pfeffermominee690-afk/ti60-five-style-fit34/README.md

# 流光绘影：FPGA 实时视频风格化系统

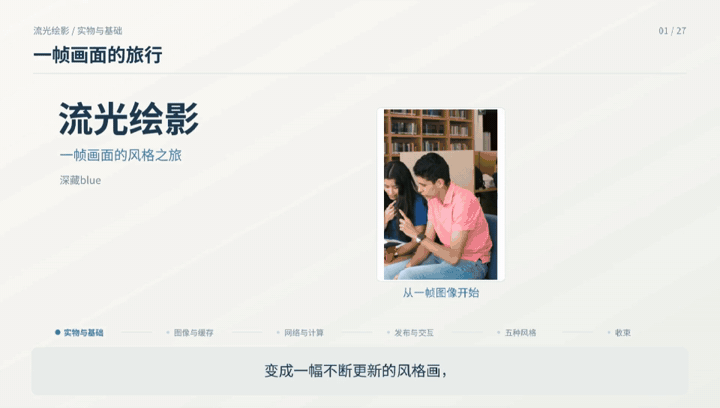
[picture p1: docs/media/previews/liuguang-showcase.gif]
流光绘影完整视频动态预览，点击播放 (https://pfeffermominee690-afk.github.io/ti60-five-style-fit34/)


**[▶ 播放完整视频 · 原理与成果展示](https://pfeffermominee690-afk.github.io/ti60-five-style-fit34/)**　960×544 · 8 分 28 秒　[下载 MP4 原片](https://github.com/pfeffermominee690-afk/ti60-five-style-fit34/releases/download/showcase-selected-20261105/liuguang-selected.mp4)

本项目运行于 Ti60F225 开发板，使用 SC431HAI CSI 摄像头采集图像，经 FPGA 处理后输出至 HDMI 显示屏。工程包含五种神经网络风格、独立 Sobel 线条 Demo，以及从板载 Flash 加载程序和模型的开机自启动实现。

当前主工程为 **fit37**：保留 fit34 的 Bayer 彩点修正、自动曝光与色彩参数，将图像和 UI 整屏旋转 180°，适配屏幕安装方向。已通过真实 J4 摄像头及充电宝断电重启验证：自动出画面、方向正确、无蓝点、手势切换正常。版本与验证资料见 [fit37 说明](docs/validation/fit37/README.md)，历史版本见 [fit34 恢复材料](recovery/fit34/README.md)。

## 实机效果

摄像头采集、FPGA 风格化、HDMI 输出。以下 15 张五风格实拍按场景分组，展示副本裁去屏幕上方的面板留白，保留完整屏幕、原图对照和风格名称；点击图片可查看未裁剪原照。

[视频演示 · 4 段](#视频演示) · [现实人物 · 5 张](#现实人物) · [手机人物 · 7 张](#手机人物) · [风景 · 3 张](#风景) · [基础线稿 Demo](#基础线稿-demo)

### 视频演示

四段实机视频展示五种风格的场景与人物效果、独立线条处理和手势切换。点击动图查看完整视频；场景与人物动图为片段预览。

<table>
<tr>
<td width="50%" align="center" valign="top">
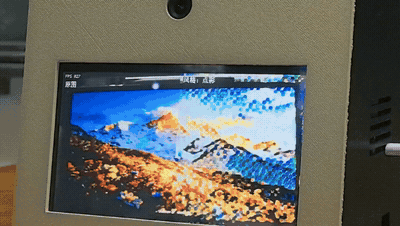
[picture p2: docs/media/previews/five-style-scenes-20261104.gif]
五种风格 · 场景混剪视频预览
<br>
<strong>五种风格 · 场景混剪</strong><br>
<a href="docs/media/originals/five-style-scenes-20261104.mp4">完整视频 · 1:48</a>
</td>
<td width="50%" align="center" valign="top">
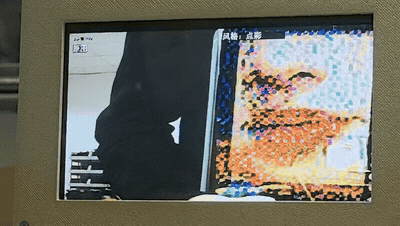
[picture p3: docs/media/previews/five-style-portraits-20261104.gif]
五种风格 · 人物混剪视频预览
<br>
<strong>五种风格 · 人物混剪</strong><br>
<a href="docs/media/videos/five-style-portraits-20261104.mp4">完整视频 · 0:49</a>
</td>
</tr>
<tr>
<td width="50%" align="center" valign="top">
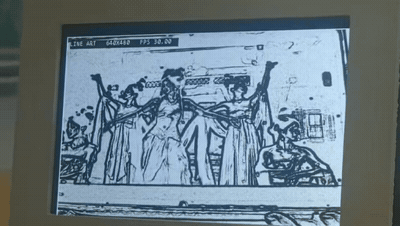
[picture p4: docs/media/previews/line-demo-20261104.gif]
独立线条测试 Demo视频预览
<br>
<strong>独立线条测试 Demo</strong><br>
<a href="docs/media/videos/line-demo-20261104.mp4">完整视频 · 0:12</a>
</td>
<td width="50%" align="center" valign="top">
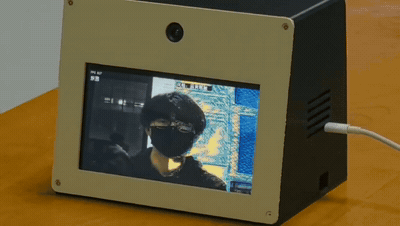
[picture p5: docs/media/previews/gesture-switch-20261104.gif]
手势切换演示视频预览
<br>
<strong>手势切换演示</strong><br>
<a href="docs/media/videos/gesture-switch-20261104.mp4">完整视频 · 0:24</a>
</td>
</tr>
</table>

[浏览全部视频与原始文件](docs/media/README.md)

### 现实人物

同一室内场景，呈现五种风格下的人物、衣物与背景。

<table>
<tr>
<td width="50%" align="center" valign="middle" rowspan="2">
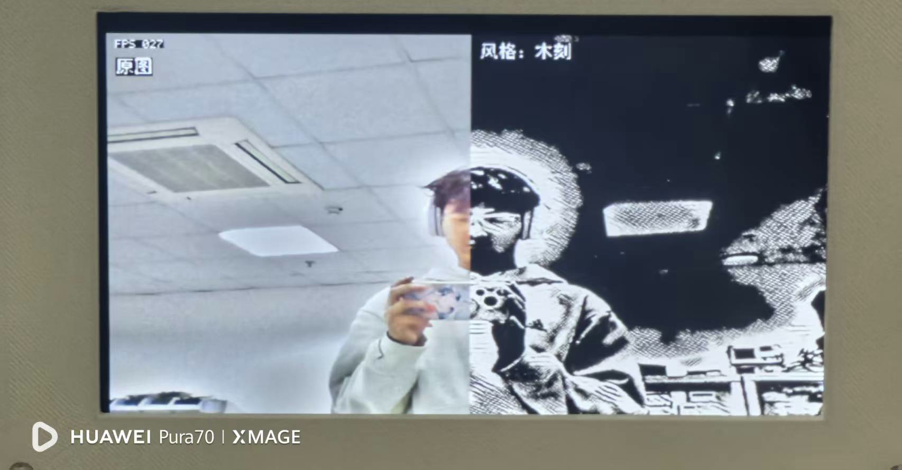
[picture p6: docs/gallery/display/real-people/display-10.png]
木刻：显示屏左侧原图与右侧风格化结果
<br>
<strong>木刻</strong>
</td>
<td width="25%" align="center" valign="middle">
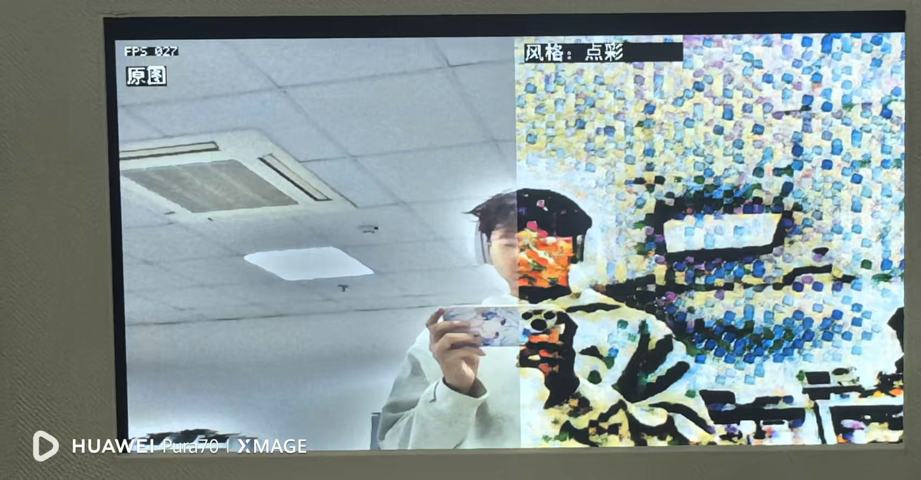
[picture p7: docs/gallery/display/real-people/display-11.png]
点彩：显示屏左侧原图与右侧风格化结果
<br>
<strong>点彩</strong>
</td>
<td width="25%" align="center" valign="middle">
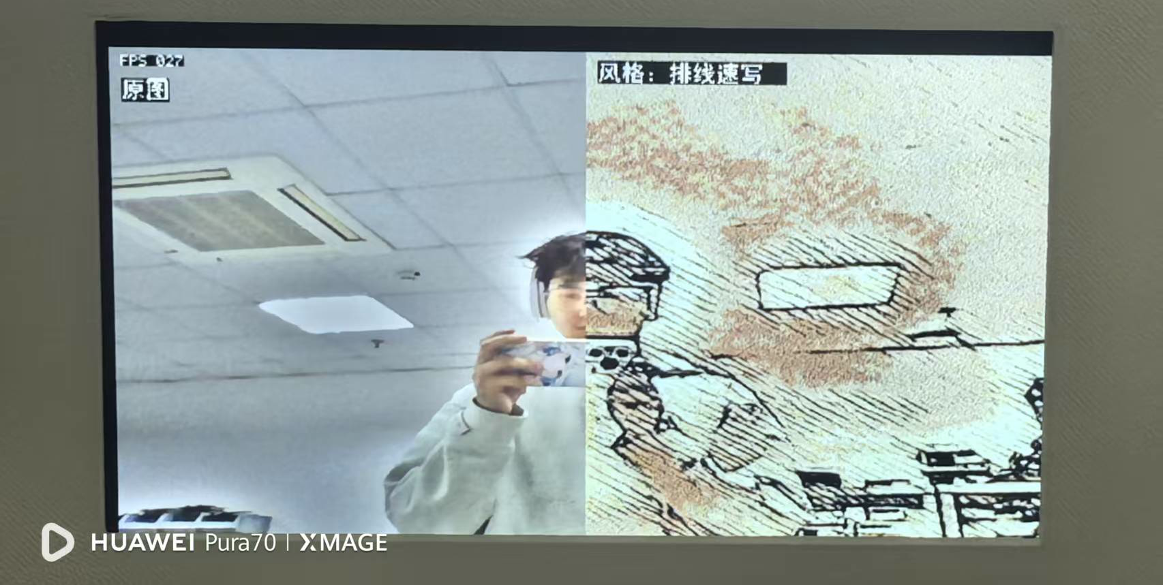
[picture p8: docs/gallery/display/real-people/display-08.png]
<br>
<strong>排线速写</strong>
</td>
</tr>
<tr>
<td width="25%" align="center" valign="middle">
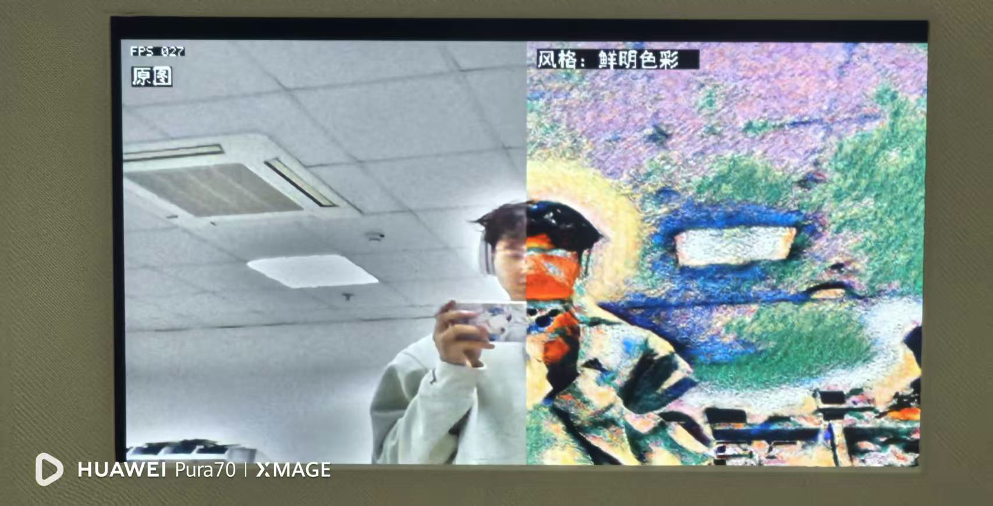
[picture p9: docs/gallery/display/real-people/display-12.png]
鲜明色彩：显示屏左侧原图与右侧风格化结果
<br>
<strong>鲜明色彩</strong>
</td>
<td width="25%" align="center" valign="middle">
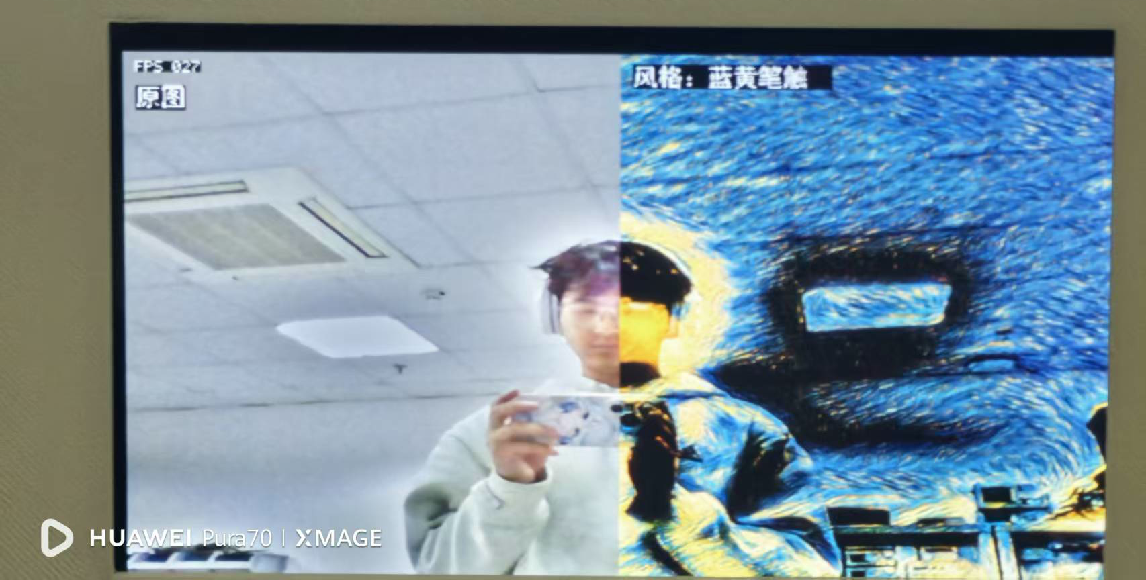
[picture p10: docs/gallery/display/real-people/display-09.png]
蓝黄笔触：显示屏左侧原图与右侧风格化结果
<br>
<strong>蓝黄笔触</strong>
</td>
</tr>
</table>

### 手机人物

以手机中的人物画面作为拍摄对象，展示五种风格及不同构图下的木刻效果。

<table>
<tr>
<td width="100%" align="center" valign="middle" colspan="2">
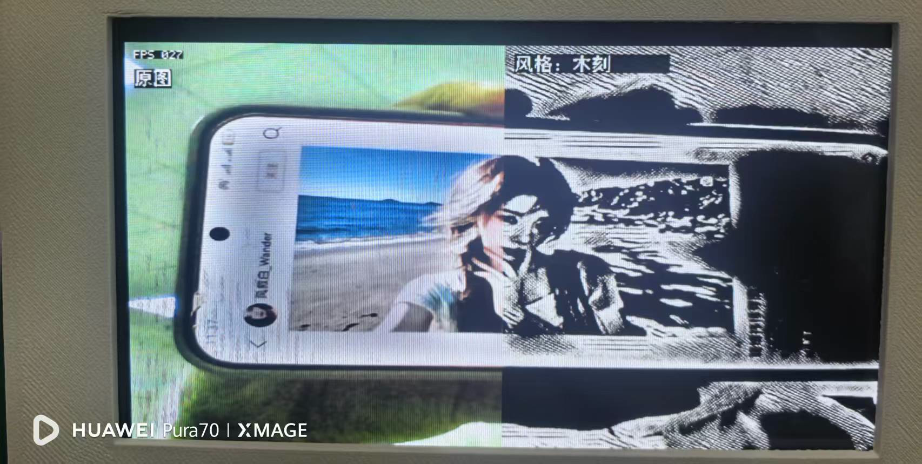
[picture p11: docs/gallery/display/phone-portraits/display-02.png]
木刻 · 横屏画面
<br>
<strong>木刻 · 横屏画面</strong>
</td>
</tr>
<tr>
<td width="50%" align="center" valign="middle">
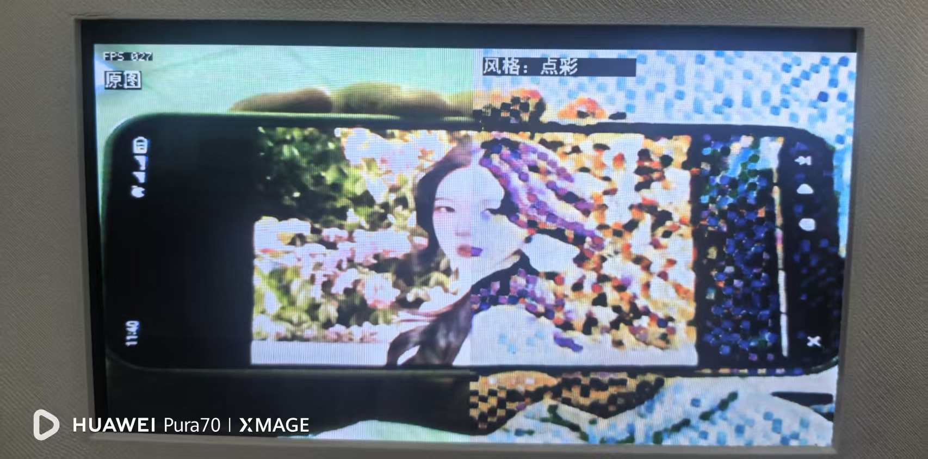
[picture p12: docs/gallery/display/phone-portraits/display-04.png]
点彩
<br>
<strong>点彩</strong>
</td>
<td width="50%" align="center" valign="middle">
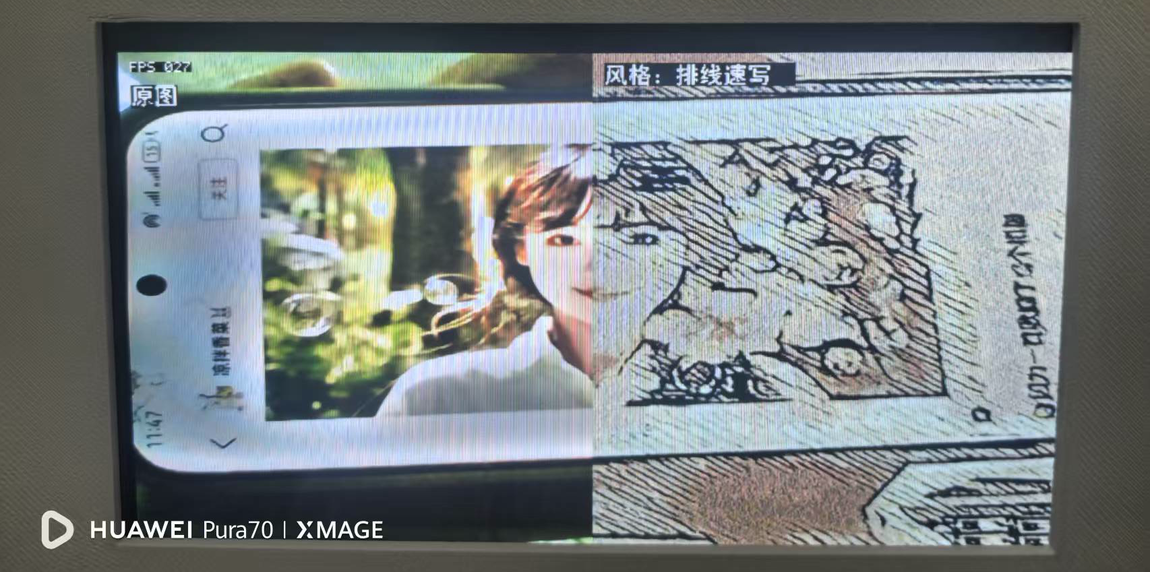
[picture p13: docs/gallery/display/phone-portraits/display-01.png]
排线速写
<br>
<strong>排线速写</strong>
</td>
</tr>
<tr>
<td width="50%" align="center" valign="middle">
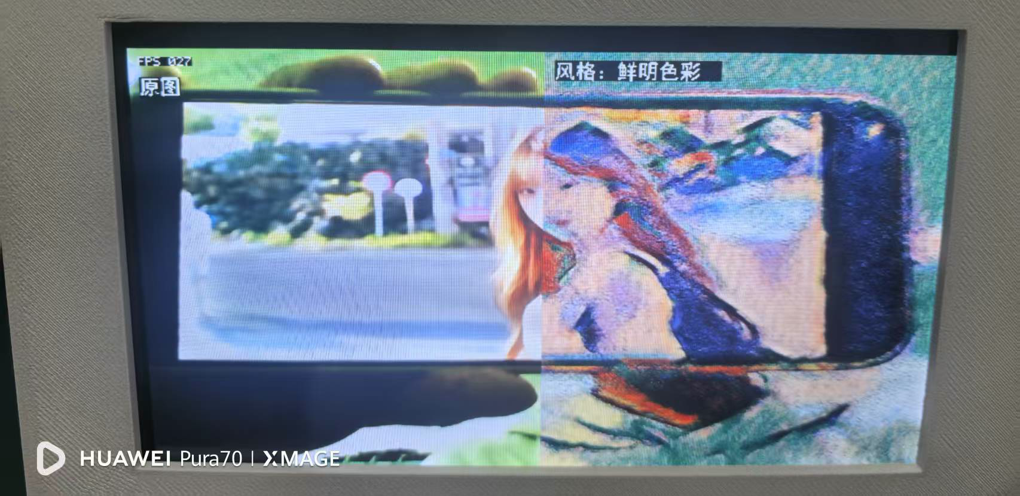
[picture p14: docs/gallery/display/phone-portraits/display-06.png]
鲜明色彩
<br>
<strong>鲜明色彩</strong>
</td>
<td width="50%" align="center" valign="middle">
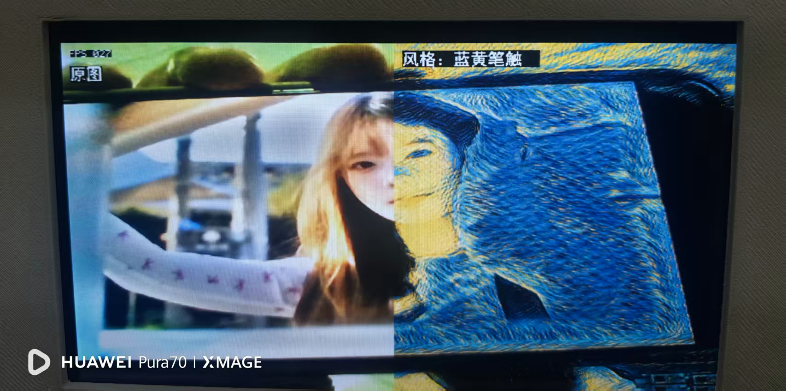
[picture p15: docs/gallery/display/phone-portraits/display-07.png]
蓝黄笔触
<br>
<strong>蓝黄笔触</strong>
</td>
</tr>
<tr>
<td width="50%" align="center" valign="middle">
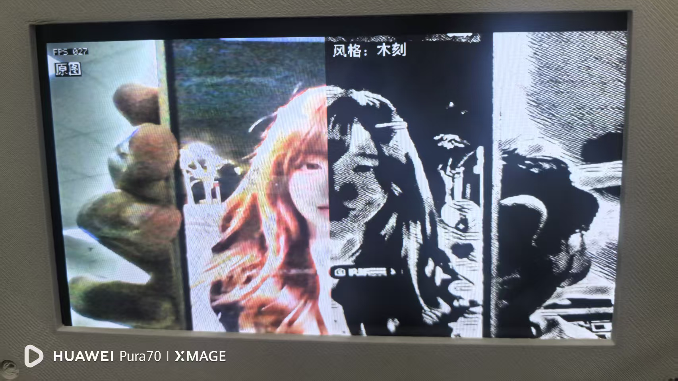
[picture p16: docs/gallery/display/phone-portraits/display-03.png]
木刻 · 人物近景
<br>
<strong>木刻 · 人物近景</strong>
</td>
<td width="50%" align="center" valign="middle">
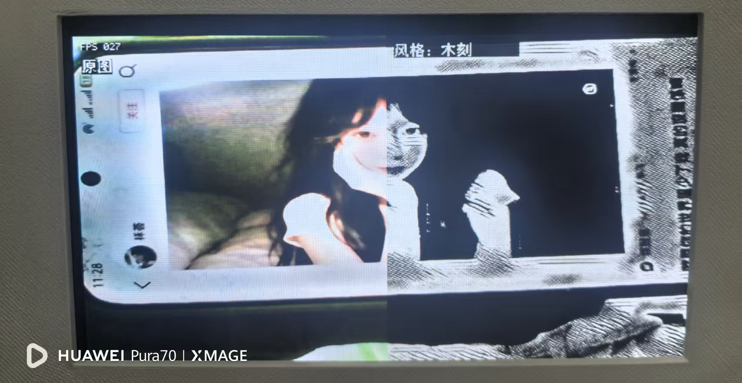
[picture p17: docs/gallery/display/phone-portraits/display-05.png]
木刻 · 不同构图
<br>
<strong>木刻 · 不同构图</strong>
</td>
</tr>
</table>

### 风景

山体与树林的色彩、纹理和轮廓，在蓝黄笔触与排线速写中呈现不同效果。

<table>
<tr>
<td width="67%" align="center" valign="middle" rowspan="2">
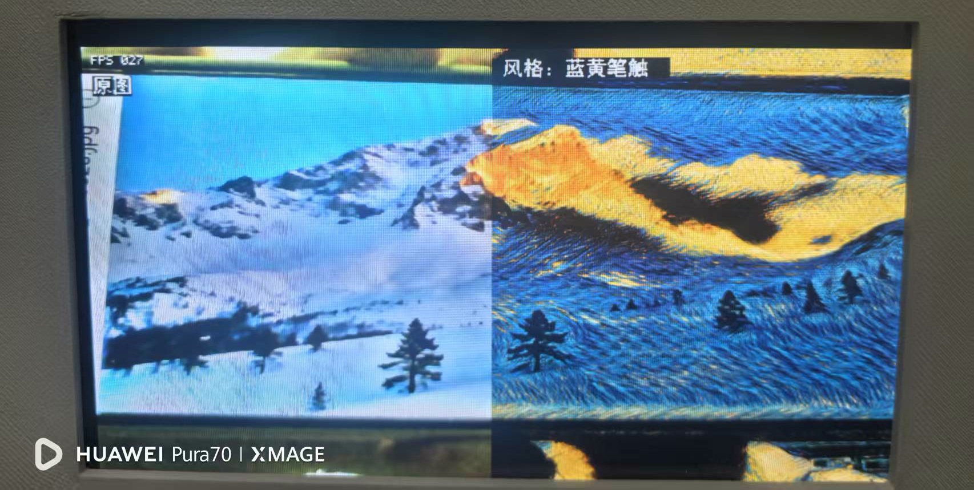
[picture p18: docs/gallery/display/landscapes/display-13.png]
蓝黄笔触 · 山景：显示屏左侧原图与右侧风格化结果
<br>
<strong>蓝黄笔触 · 山景</strong>
</td>
<td width="33%" align="center" valign="middle">
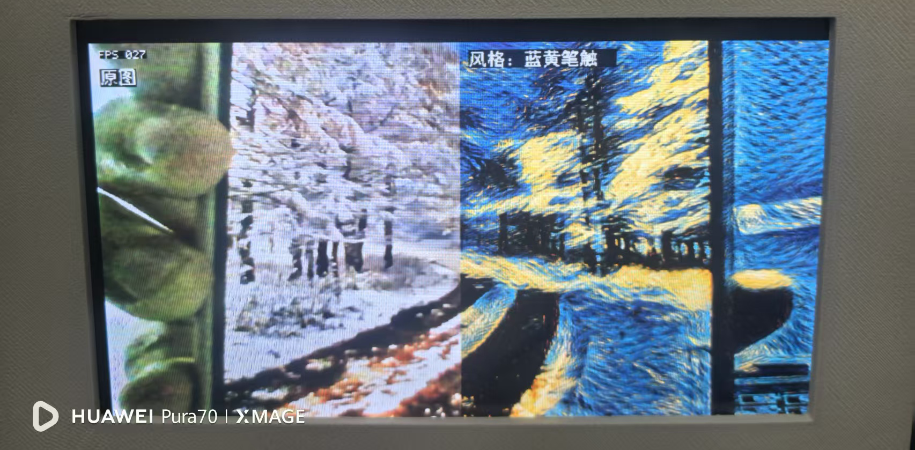
[picture p19: docs/gallery/display/landscapes/display-15.png]
蓝黄笔触 · 树林：显示屏左侧原图与右侧风格化结果
<br>
<strong>蓝黄笔触 · 树林</strong>
</td>
</tr>
<tr>
<td width="33%" align="center" valign="middle">
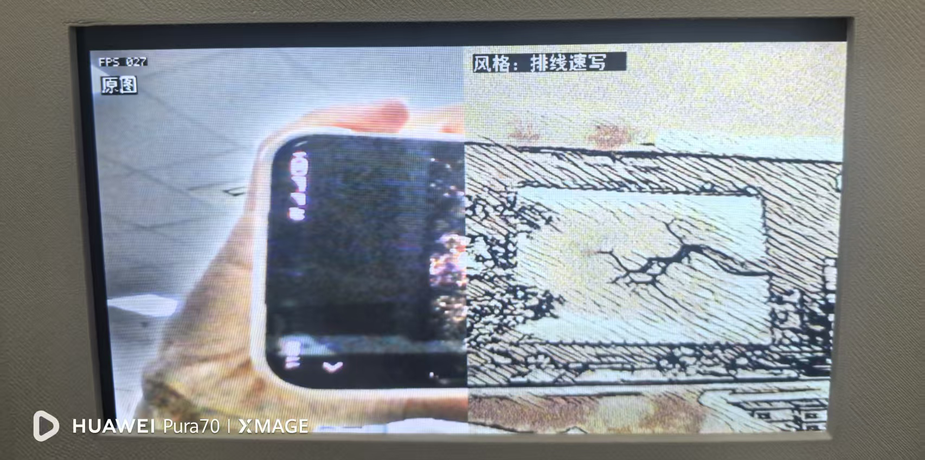
[picture p20: docs/gallery/display/landscapes/display-14.png]
<br>
<strong>排线速写</strong>
</td>
</tr>
</table>

[浏览全部原始照片与分组索引](docs/gallery/README.md)

### 基础线稿 Demo

独立 Sobel 工程将摄像头画面转换为黑白线稿，以 640×480 分辨率输出至 HDMI 显示屏。源码与运行方法见 [线条 Demo](line-demo/README.md)。

<p align="center">
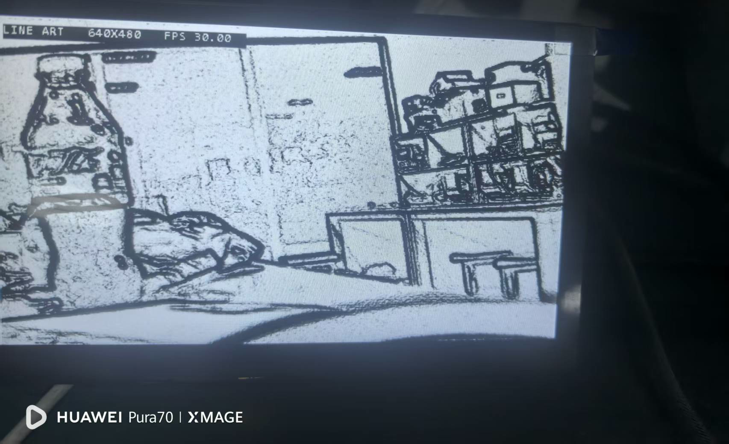
[picture p21: docs/gallery/display/line-demo/line-art.png]
基础 Sobel 线稿 Demo 实拍：瓶子与室内物体的黑白轮廓，屏幕显示 LINE ART 640X480 FPS 30.00
<br>
<strong>基础线稿 Demo · 实机效果</strong>
</p>

## 外壳与机械设计

两套外壳均由团队自主建模并采用 3D 打印制作。第一套采用前置摄像头布局，镜头与屏幕位于同侧；第二套采用后置摄像头布局，镜头位于屏幕背面。外壳使用 ABS、PLA Basic、PETG 等材料，整机由充电宝供电。

### 两套实物：前置与后置摄像头

<table>
<tr>
<td width="33%" align="center" valign="top">
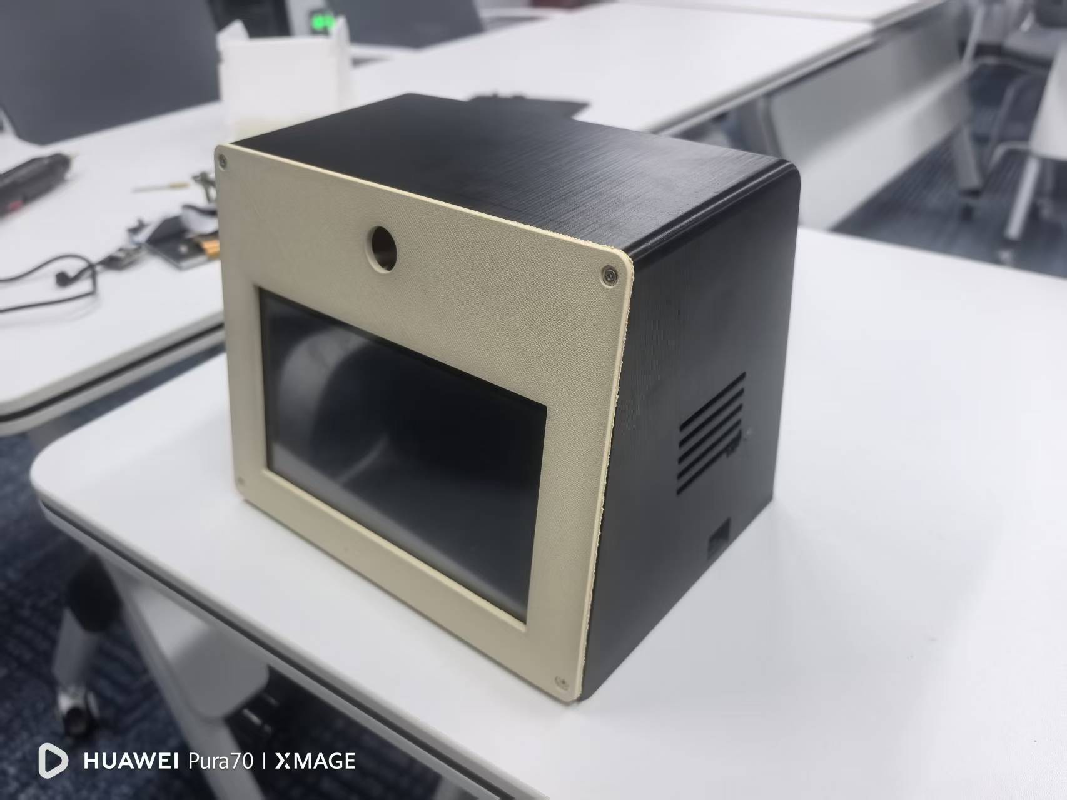
[picture p22: docs/enclosures/originals/same-side/A01.jpg]
第一套外壳：前置摄像头与屏幕位于同一面
<br>
<strong>第一套 · 前置摄像头与屏幕</strong>
</td>
<td width="34%" align="center" valign="top">
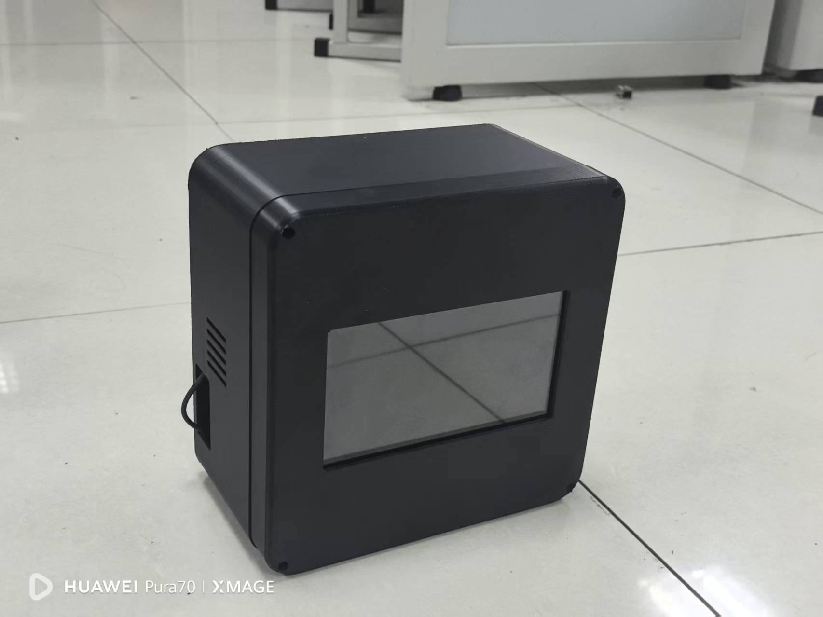
[picture p23: docs/enclosures/originals/opposite-side/B02.jpg]
第二套外壳正面：显示屏，摄像头位于另一面
<br>
<strong>第二套 · 正面屏幕</strong>
</td>
<td width="33%" align="center" valign="top">
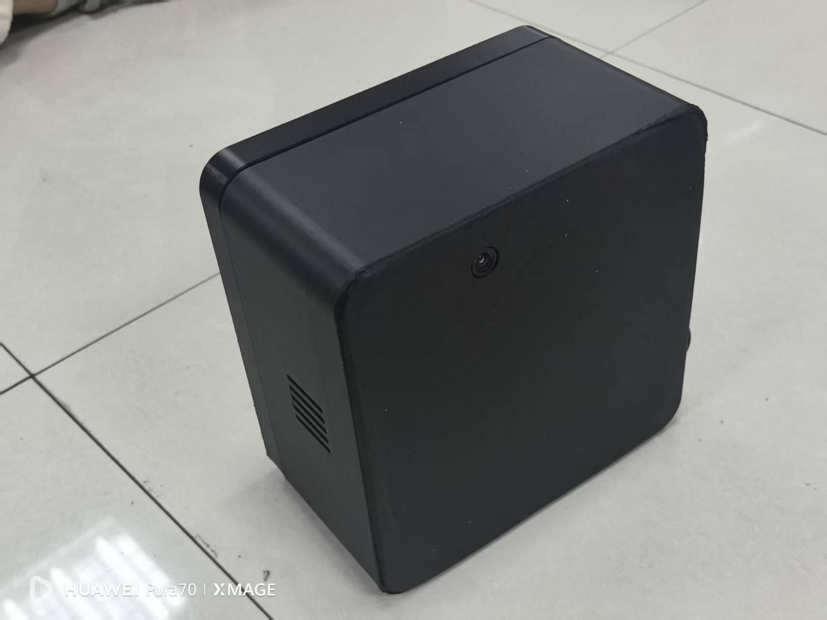
[picture p24: docs/enclosures/originals/opposite-side/B04.jpg]
第二套外壳背面：后置摄像头，与屏幕分置两面
<br>
<strong>第二套 · 后置摄像头</strong>
</td>
</tr>
</table>

### 内部装配与开发板

<table>
<tr>
<td width="50%" align="center" valign="top">
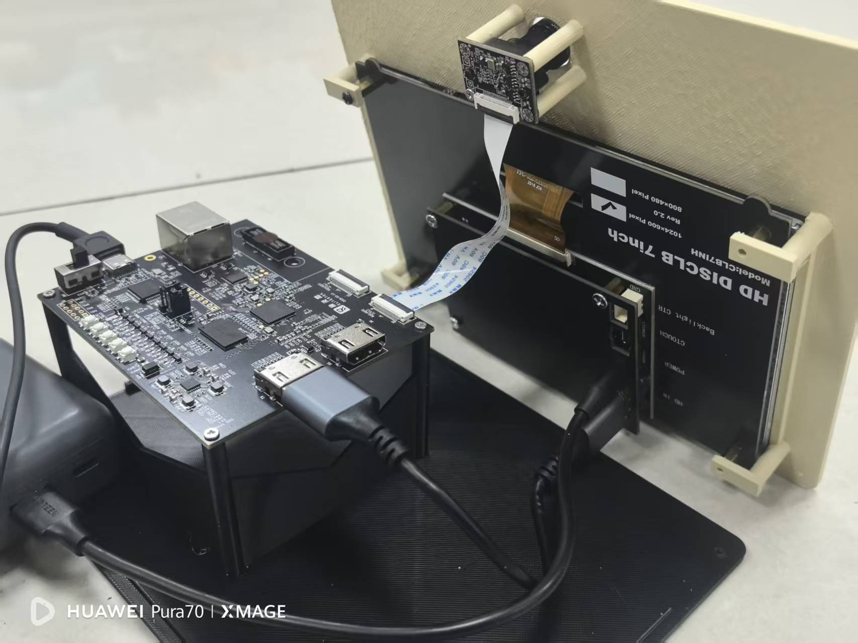
[picture p25: docs/enclosures/originals/same-side/A04.jpg]
第一套内部装配：Ti60 开发板、摄像头排线与显示屏连接
<br>
<strong>第一套 · 开发板与前面板连接</strong>
</td>
<td width="50%" align="center" valign="top">
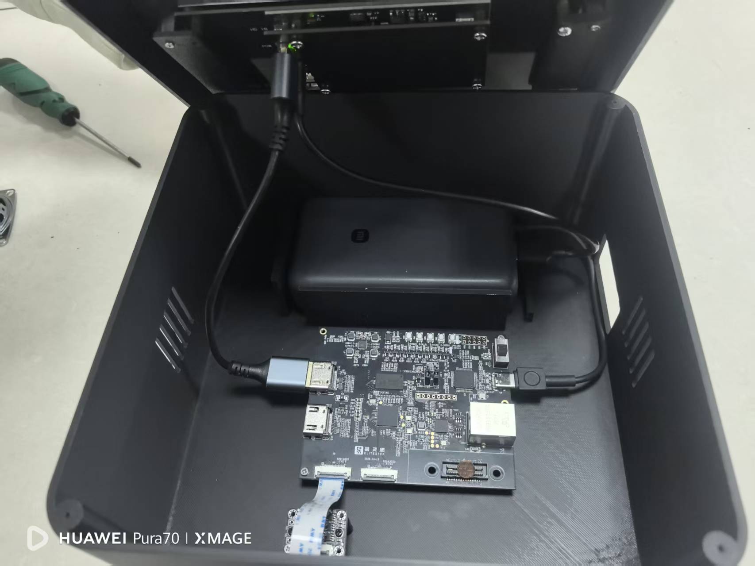
[picture p26: docs/enclosures/originals/opposite-side/B03.jpg]
第二套内部装配：Ti60 开发板、后置摄像头、显示屏与移动电源
<br>
<strong>第二套 · 开发板与内部布局</strong>
</td>
</tr>
</table>

### 三维装配与分解图

<table>
<tr>
<td width="50%" align="center" valign="middle">
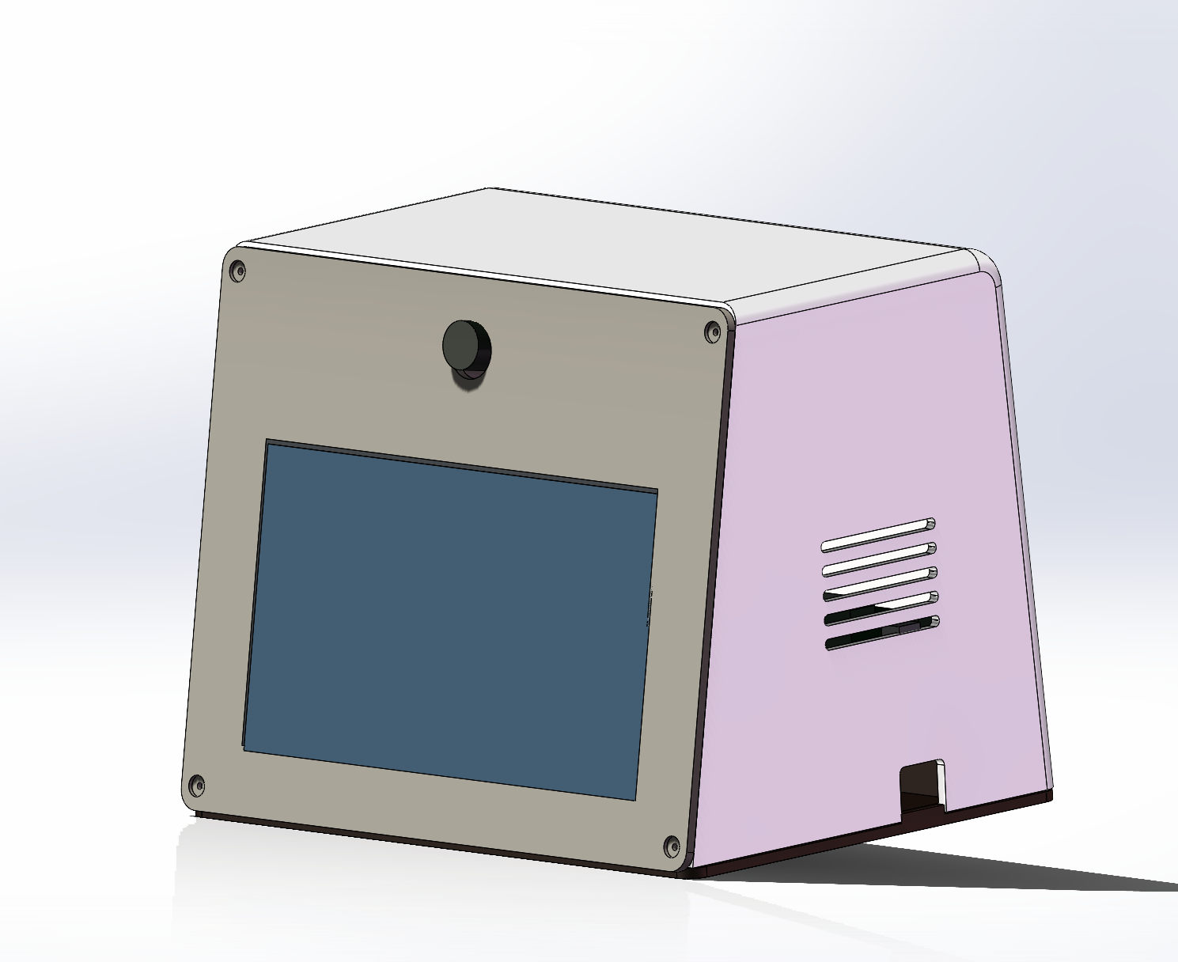
[picture p27: docs/enclosures/originals/same-side/A02.png]
第一套 · 整体装配模型
<br>
<strong>第一套 · 整体装配模型</strong>
</td>
<td width="50%" align="center" valign="middle">
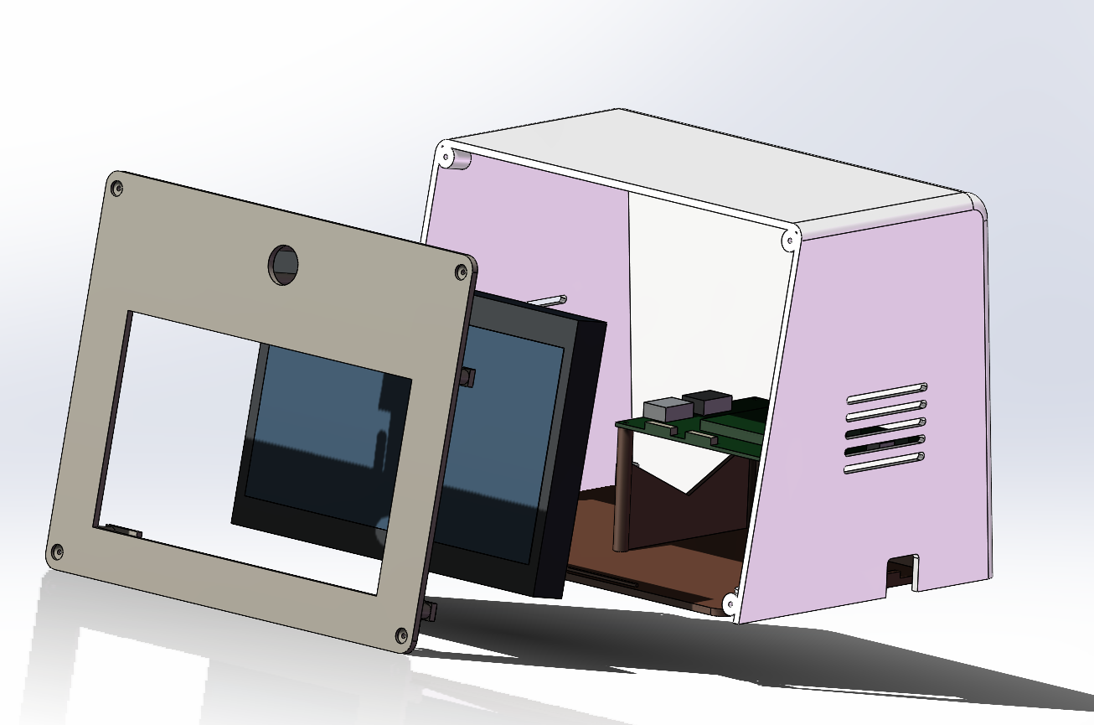
[picture p28: docs/enclosures/originals/same-side/A09.png]
第一套 · 分解模型
<br>
<strong>第一套 · 分解模型</strong>
</td>
</tr>
<tr>
<td width="50%" align="center" valign="middle">
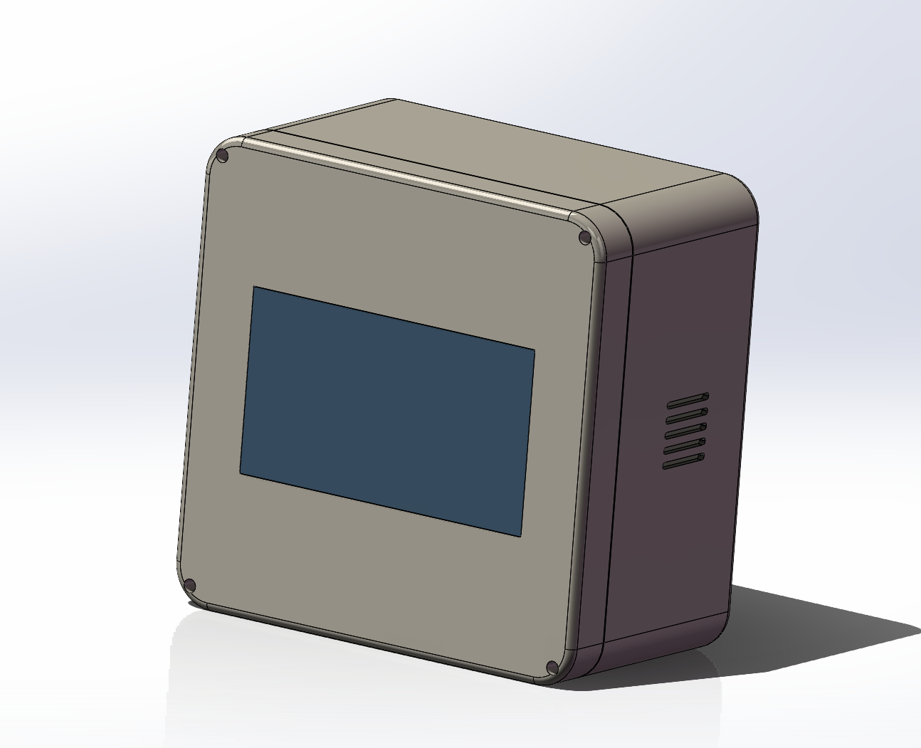
[picture p29: docs/enclosures/originals/opposite-side/B07.png]
第二套 · 整体装配模型
<br>
<strong>第二套 · 整体装配模型</strong>
</td>
<td width="50%" align="center" valign="middle">
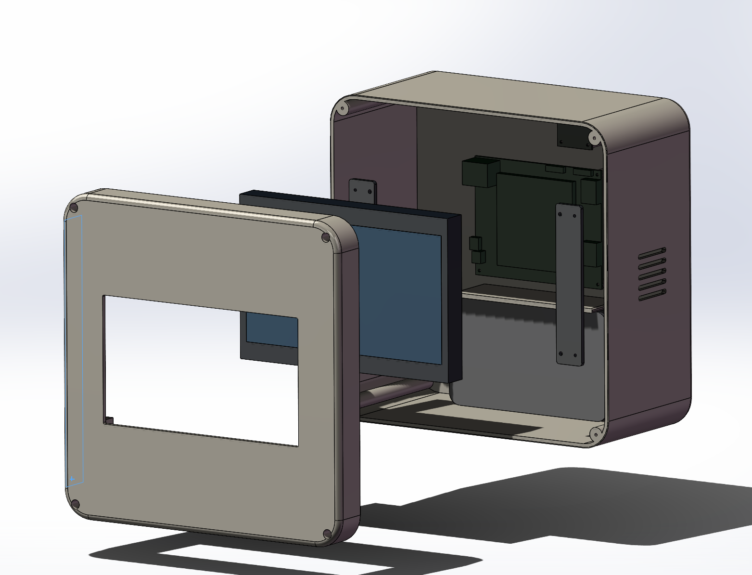
[picture p30: docs/enclosures/originals/opposite-side/B05.png]
第二套 · 分解模型
<br>
<strong>第二套 · 分解模型</strong>
</td>
</tr>
</table>

[查看全部 12 张实物照片与 4 张机械设计图](docs/enclosures/README.md)

## 功能与工程入口

| 工程 | 功能 | 源码目录 | 加载命令 |
|---|---|---|---|
| 五风格主工程（fit37） | 原图／风格图对照，手势切换，Bayer 彩点修正、自动曝光与整屏 180° 旋转 | `fpga/`、`firmware/` | `./load.ps1 -Target main` |
| 独立线条 Demo（Sobel v2） | 640×480 线条提取、原图旁路、单行信息显示 | `line-demo/` | `./load.ps1 -Target line` |
| 历史自启动工程（fit32） | 固定曝光，上电从 Flash 加载模型并校验 CRC | `autoboot/` | `./load.ps1 -Target autoboot` |

fit37 的片内固件包含 Flash 模型加载与 CRC 校验，沿用 fit34 的自动曝光；`autoboot/` 保留 fit32 的独立历史工程。各版本的位流、固件和源码对应关系由校验清单固定。`load.ps1` 用于 JTAG 运行，`-Target fit34` 可恢复未旋转显示；fit37 与 fit32 的 Flash 烧录方法见 [自启动说明](autoboot/README.md)。

屏幕上的五种风格名称及切换顺序为：**木刻 → 点彩 → 排线速写 → 鲜明色彩 → 蓝黄笔触**。“原图”用于并排对照。在镜头前水平挥手可切换风格；保持摄像头固定，连续动作之间稍作停顿。模型对应关系见 [模型说明](models/README.md)。独立线条 Demo 显示 `LINE ART`，与五风格中的“排线速写”分别实现。

## 硬件与开发环境

- Ti60F225 开发板、配套 SC431HAI 摄像头、HDMI 显示屏、USB 调试线和开发板电源。
- 摄像头接开发板 CSI 接口 J4；显示屏接 HDMI TX；USB 调试接口连接电脑。
- Windows、Efinity 2025.1、Efinix RISC-V IDE 2025.1、Python 3。模型导出另需 `model-source/requirements.txt`；仿真使用 Linux/WSL 的 GCC、Icarus Verilog 和 Verilator。

## 运行与编译

在项目根目录打开 PowerShell，先运行 `python tools/verify.py` 检查文件，再执行上表中的加载命令。五风格工程需要 Flash 中已有配套模型；首次配置使用自启动说明中的模型与配置烧录流程。线条 Demo 不依赖模型。

```powershell
# 编译三个固件，输出到 build/ 对应子目录
python tools/build_firmware.py --target main
python tools/build_firmware.py --target line
python tools/build_firmware.py --target autoboot

# 修改固件后，先更新片内 RAM 初值，再编译对应 FPGA 工程
python tools/build_firmware.py --target line --update-ram
./build-fpga.ps1 -Target line
```

编译目标为 `main`、`line`、`autoboot`。FPGA 输出位于相应工程的 `fpga/outflow/`；`prebuilt/` 保存配套参考文件。`load.ps1` 加载的是参考文件，并额外提供 `fit34` 恢复选项。工具安装位置不同，可指定 `-EfinityHome`、`-RiscvSdk` 或 `--toolchain`。

## 其他源码与验证

- `models/`：部署模型；`model-source/`：模型源码、检查点与量化参数；`tools/export_models.py`：部署模型导出。
- `firmware/vendor/`：三个工程共用的 BSP、启动汇编和驱动；`tools/generate_fonts.py`：屏幕中文字模及线条 Demo 字模生成。
- `tests/`、`line-demo/tests/`、`autoboot/tests/`：算法、显示、采集与启动测试。运行方法见 [测试说明](tests/README.md)。
- `manifest.json`：整包 SHA-256；各工程的 `source-manifest.json`：源码与参考位流、ELF 的对应关系。

厂商 IP 和模型代码保留各自的版权与许可。
