pfeffermominee690-afk/ti60-five-style-fit34/docs/enclosures/README.md

# 外壳实物与机械设计

两套外壳均由团队自主建模并采用 3D 打印制作。第一套采用前置摄像头布局，镜头与屏幕位于同侧；第二套采用后置摄像头布局，镜头位于屏幕背面。外壳使用 ABS、PLA Basic、PETG 等材料，整机由充电宝供电。

全部 16 张图片保留原始内容，点击可查看原图。

## 第一套：摄像头与屏幕同侧

### 实物与装配

<table>
<tr>
<td width="50%" align="center" valign="middle">
<a href="originals/same-side/A01.jpg">第一套 · 整机外观</a><br>
<strong>第一套 · 整机外观</strong>
</td>
<td width="50%" align="center" valign="middle">
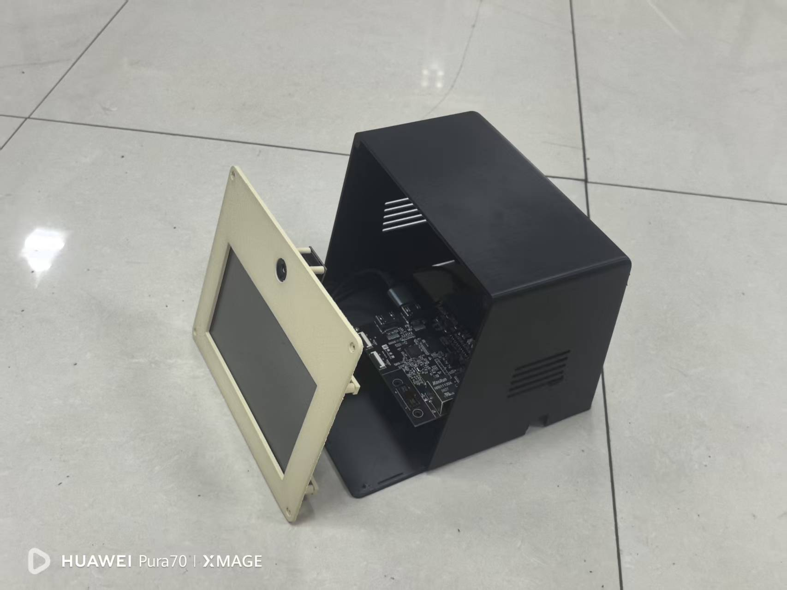
[picture p31: docs/enclosures/originals/same-side/A03.jpg]
第一套 · 前面板拆装
<br>
<strong>第一套 · 前面板拆装</strong>
</td>
</tr>
<tr>
<td width="50%" align="center" valign="middle">
<a href="originals/same-side/A04.jpg">第一套 · 内部连接</a><br>
<strong>第一套 · 内部连接</strong>
</td>
<td width="50%" align="center" valign="middle">
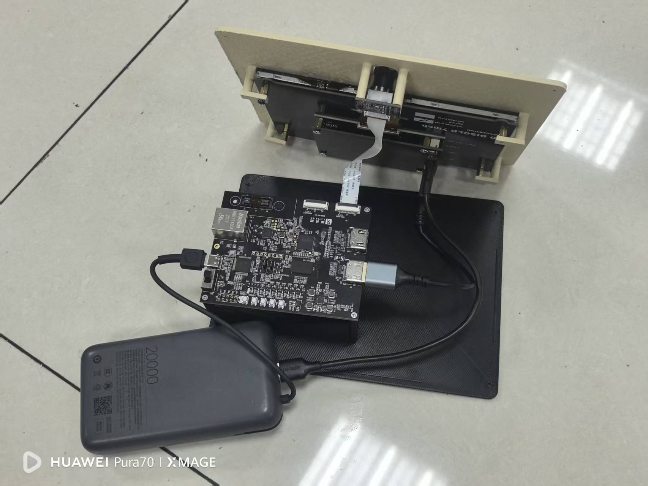
[picture p32: docs/enclosures/originals/same-side/A05.jpg]
第一套 · 接线与供电布局
<br>
<strong>第一套 · 接线与供电布局</strong>
</td>
</tr>
<tr>
<td width="50%" align="center" valign="middle">
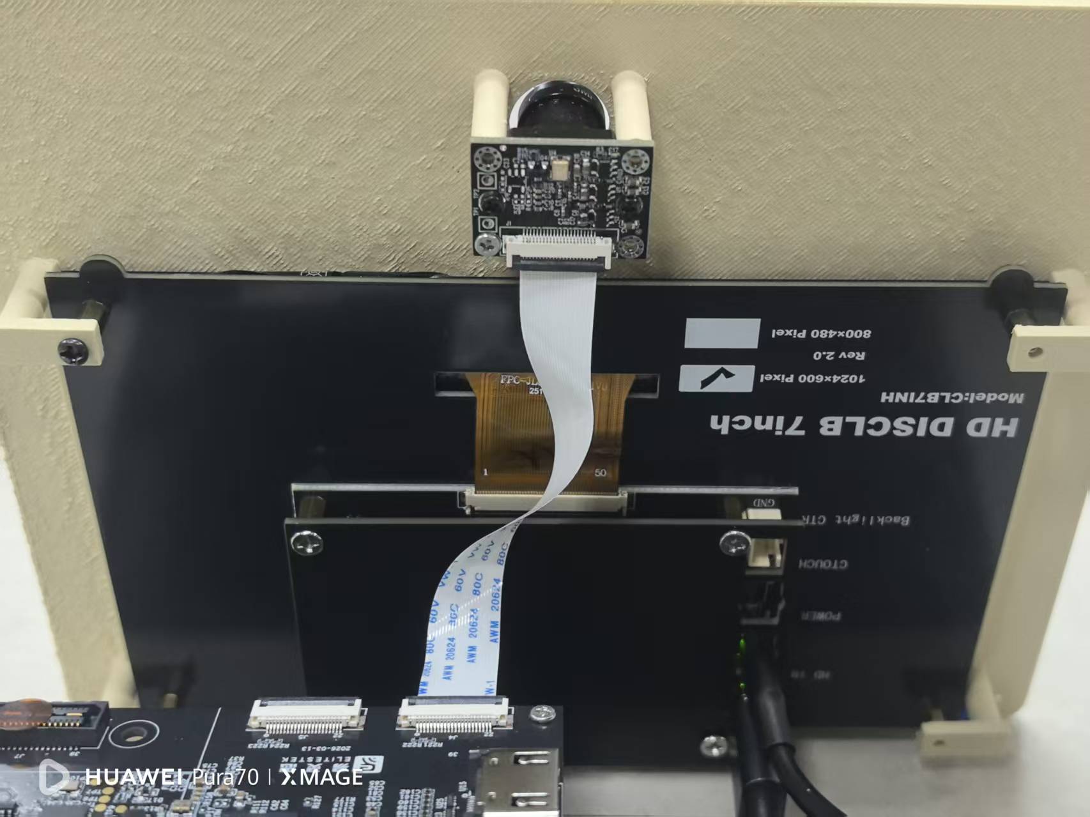
[picture p33: docs/enclosures/originals/same-side/A06.jpg]
第一套 · 相机与屏幕固定
<br>
<strong>第一套 · 相机与屏幕固定</strong>
</td>
<td width="50%" align="center" valign="middle">
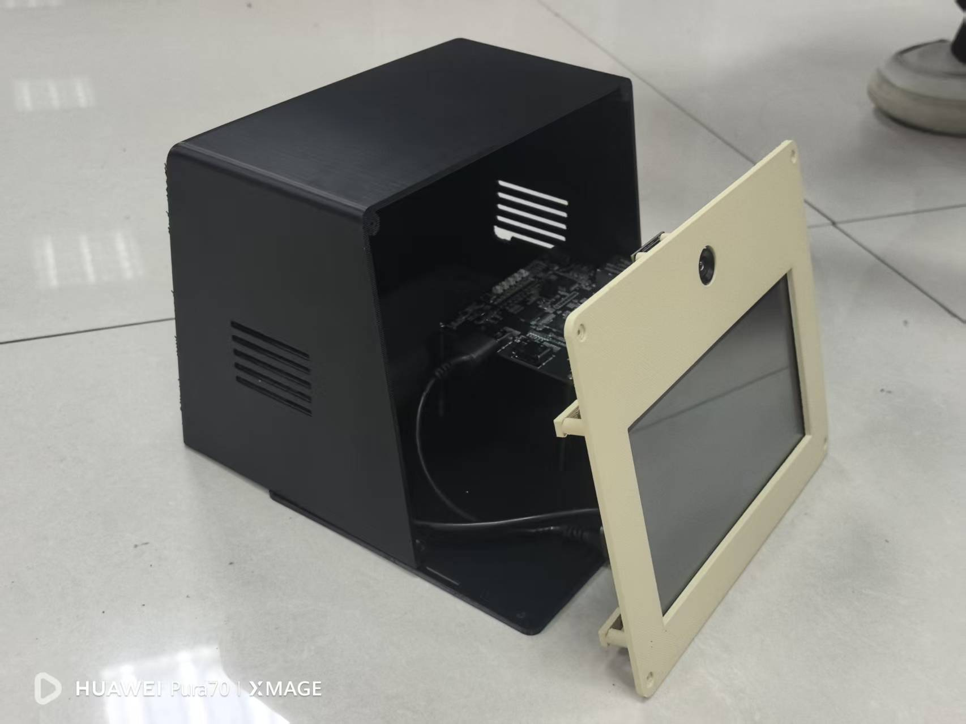
[picture p34: docs/enclosures/originals/same-side/A07.jpg]
第一套 · 侧面与通风槽
<br>
<strong>第一套 · 侧面与通风槽</strong>
</td>
</tr>
<tr>
<td width="50%" align="center" valign="middle">
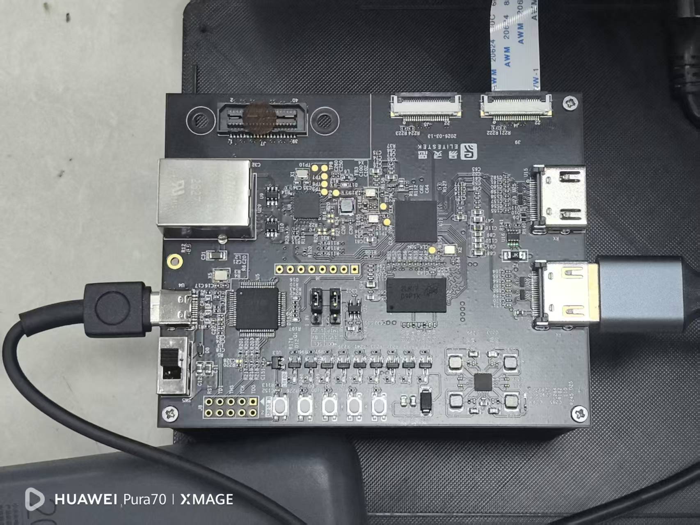
[picture p35: docs/enclosures/originals/same-side/A08.jpg]
第一套 · 主板接口
<br>
<strong>第一套 · 主板接口</strong>
</td>
<td width="50%"></td>
</tr>
</table>

### 三维机械设计

<table>
<tr>
<td width="50%" align="center" valign="middle">
<a href="originals/same-side/A02.png">第一套 · 整体装配模型</a><br>
<strong>第一套 · 整体装配模型</strong>
</td>
<td width="50%" align="center" valign="middle">
<a href="originals/same-side/A09.png">第一套 · 分解模型</a><br>
<strong>第一套 · 分解模型</strong>
</td>
</tr>
</table>

## 第二套：摄像头与屏幕异侧

### 实物与装配

<table>
<tr>
<td width="50%" align="center" valign="middle">
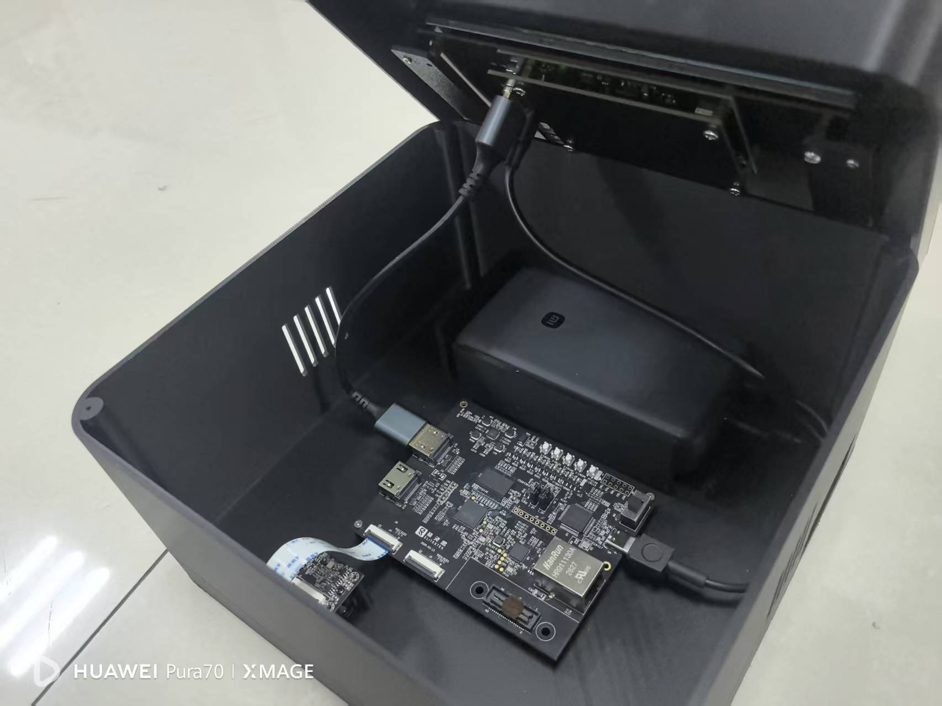
[picture p36: docs/enclosures/originals/opposite-side/B01.jpg]
第二套 · 开壳斜视
<br>
<strong>第二套 · 开壳斜视</strong>
</td>
<td width="50%" align="center" valign="middle">
<a href="originals/opposite-side/B02.jpg">第二套 · 屏幕面外观</a><br>
<strong>第二套 · 屏幕面外观</strong>
</td>
</tr>
<tr>
<td width="50%" align="center" valign="middle">
<a href="originals/opposite-side/B03.jpg">第二套 · 内部布局</a><br>
<strong>第二套 · 内部布局</strong>
</td>
<td width="50%" align="center" valign="middle">
<a href="originals/opposite-side/B04.jpg">第二套 · 镜头面外观</a><br>
<strong>第二套 · 镜头面外观</strong>
</td>
</tr>
<tr>
<td width="50%" align="center" valign="middle">
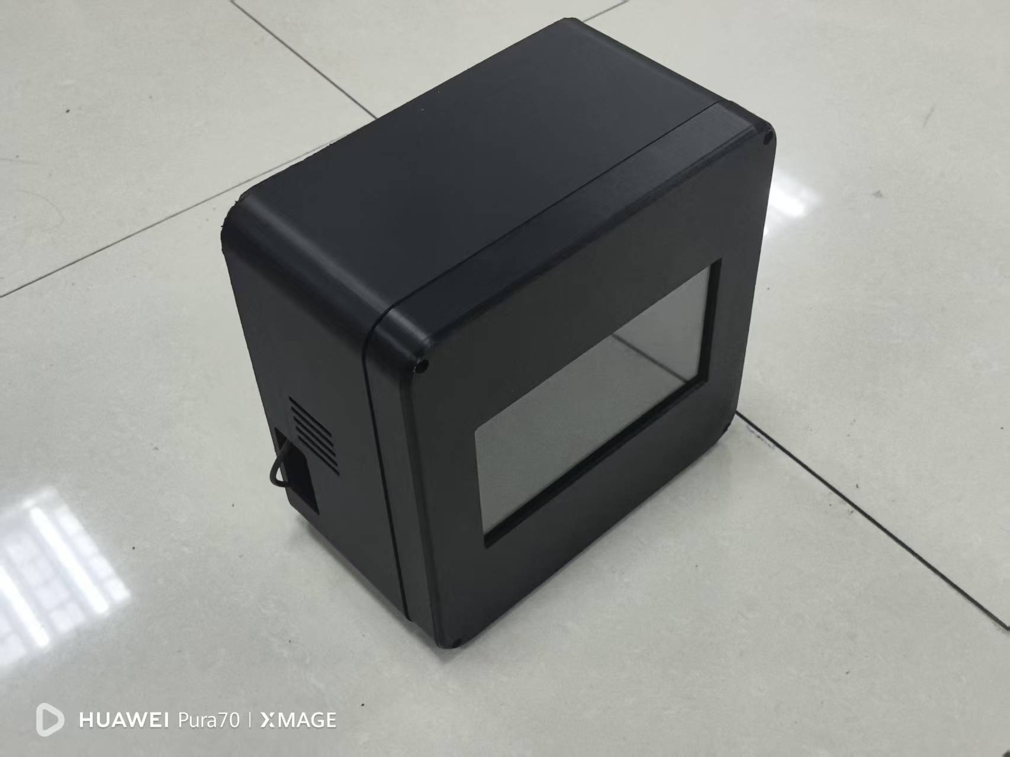
[picture p37: docs/enclosures/originals/opposite-side/B06.jpg]
第二套 · 屏幕面侧视
<br>
<strong>第二套 · 屏幕面侧视</strong>
</td>
<td width="50%"></td>
</tr>
</table>

### 三维机械设计

<table>
<tr>
<td width="50%" align="center" valign="middle">
<a href="originals/opposite-side/B05.png">第二套 · 分解模型</a><br>
<strong>第二套 · 分解模型</strong>
</td>
<td width="50%" align="center" valign="middle">
<a href="originals/opposite-side/B07.png">第二套 · 整体装配模型</a><br>
<strong>第二套 · 整体装配模型</strong>
</td>
</tr>
</table>

原始文件名与 SHA-256 见 [图片索引](index.json)。
