pfeffermominee690-afk/ti60-five-style-fit34/docs/gallery/README.md

# 显示屏实拍照片

全部 16 张原照按现实人物、手机人物、风景和基础线稿 Demo 分组保存，照片内容与原始文件一致。README 使用另存于 `display/` 的裁剪副本，去掉屏幕外的多余区域并保留完整显示画面；点击图片可查看 `originals/` 中未修改的原照。

| 分组 | 图片 | 风格／画面 |
|---|---|---|
| 现实人物 | [查看原照](originals/real-people/display-10.jpg) | 木刻 |
| 现实人物 | [查看原照](originals/real-people/display-11.jpg) | 点彩 |
| 现实人物 | [查看原照](originals/real-people/display-08.jpg) | 排线速写 |
| 现实人物 | [查看原照](originals/real-people/display-12.jpg) | 鲜明色彩 |
| 现实人物 | [查看原照](originals/real-people/display-09.jpg) | 蓝黄笔触 |
| 手机人物 | [查看原照](originals/phone-portraits/display-03.jpg) | 木刻 · 人物近景 |
| 手机人物 | [查看原照](originals/phone-portraits/display-04.jpg) | 点彩 |
| 手机人物 | [查看原照](originals/phone-portraits/display-01.jpg) | 排线速写 |
| 手机人物 | [查看原照](originals/phone-portraits/display-06.jpg) | 鲜明色彩 |
| 手机人物 | [查看原照](originals/phone-portraits/display-07.jpg) | 蓝黄笔触 |
| 手机人物 | [查看原照](originals/phone-portraits/display-02.jpg) | 木刻 · 横屏画面 |
| 手机人物 | [查看原照](originals/phone-portraits/display-05.jpg) | 木刻 · 不同构图 |
| 风景 | [查看原照](originals/landscapes/display-13.jpg) | 蓝黄笔触 · 山景 |
| 风景 | [查看原照](originals/landscapes/display-15.jpg) | 蓝黄笔触 · 树林 |
| 风景 | [查看原照](originals/landscapes/display-14.jpg) | 排线速写 |
| 基础线稿 Demo | [查看原照](originals/line-demo/line-art.jpg) | Sobel 黑白线稿 |

文件名对应关系、裁剪范围、尺寸及 SHA-256 见 [index.json](index.json)。
