pfeffermominee690-afk/ti60-five-style-fit34/docs/gallery/originals/landscapes/display-13.jpg

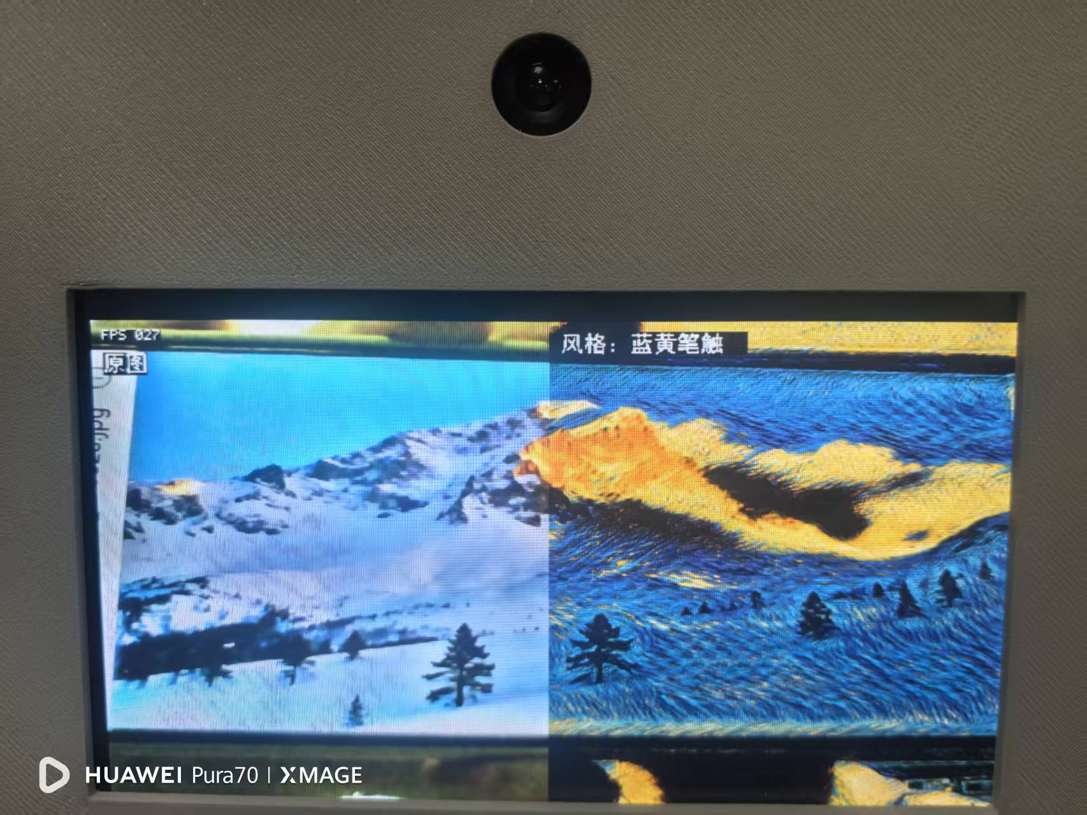
docs/gallery/originals/landscapes/display-13.jpg
