pfeffermominee690-afk/ti60-five-style-fit34/docs/gallery/originals/landscapes/display-14.jpg

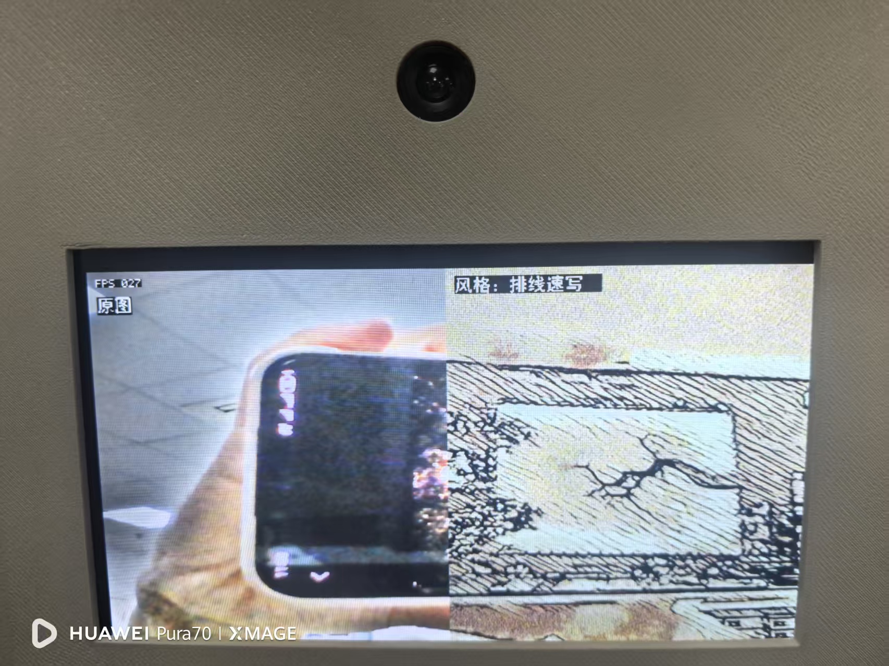
docs/gallery/originals/landscapes/display-14.jpg
