pfeffermominee690-afk/ti60-five-style-fit34/docs/gallery/originals/line-demo/line-art.jpg

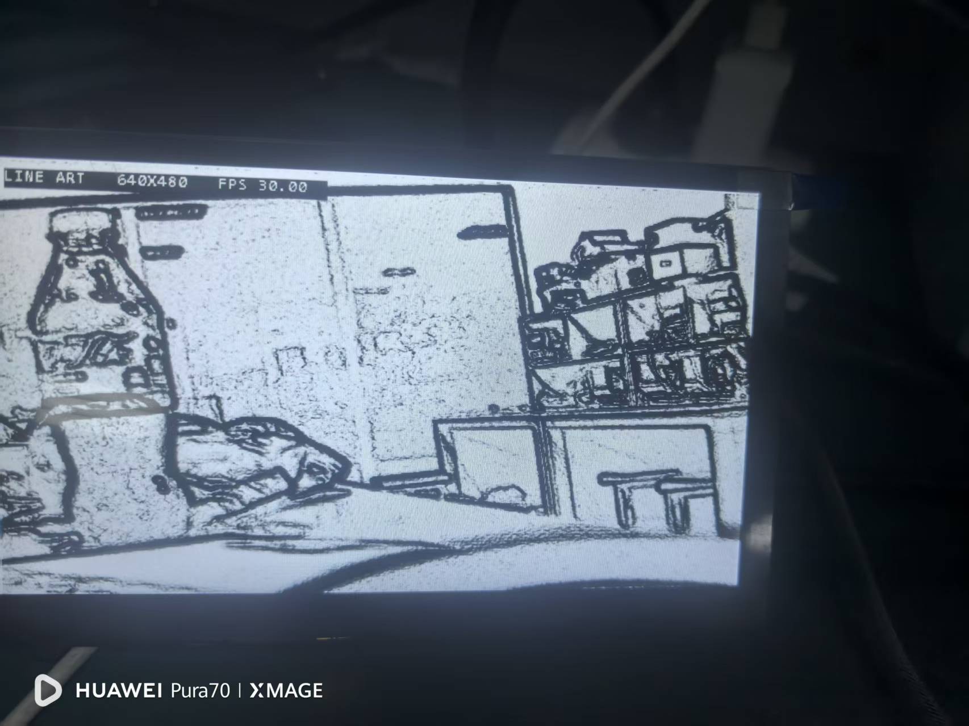
docs/gallery/originals/line-demo/line-art.jpg
