pfeffermominee690-afk/ti60-five-style-fit34/docs/gallery/originals/phone-portraits/display-05.jpg

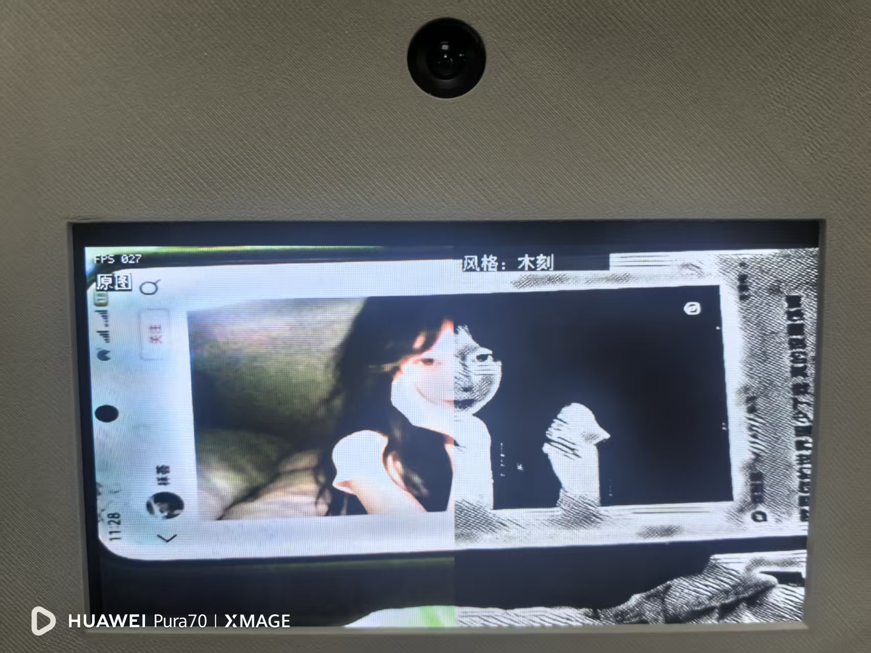
docs/gallery/originals/phone-portraits/display-05.jpg
