pfeffermominee690-afk/ti60-five-style-fit34/docs/gallery/originals/phone-portraits/display-07.jpg

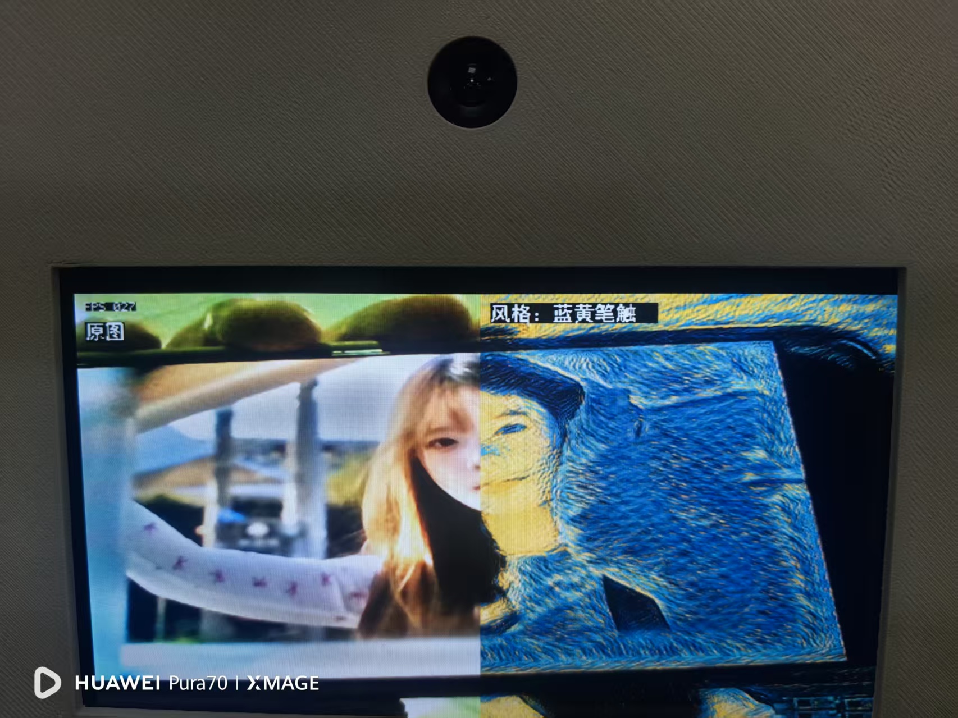
docs/gallery/originals/phone-portraits/display-07.jpg
