pfeffermominee690-afk/ti60-five-style-fit34/docs/gallery/originals/real-people/display-10.jpg

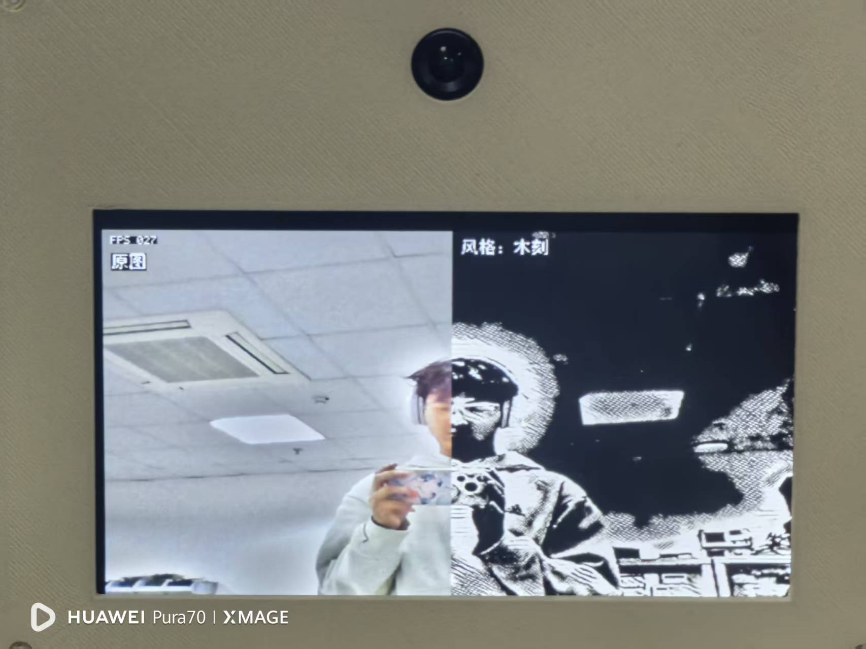
docs/gallery/originals/real-people/display-10.jpg
