pfeffermominee690-afk/ti60-five-style-fit34/docs/gallery/originals/real-people/display-11.jpg

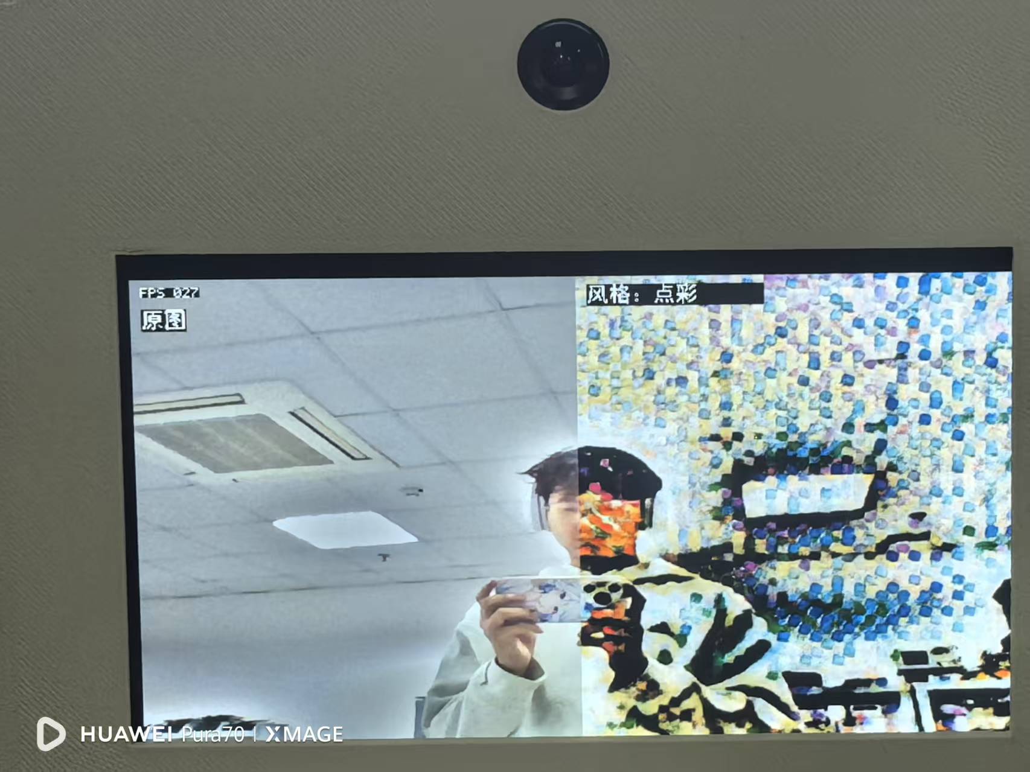
docs/gallery/originals/real-people/display-11.jpg
