pfeffermominee690-afk/ti60-five-style-fit34/line-demo/firmware/sensor_table.h

// SC431HAI: accepted board register table; stream-on is deferred until all settings are written.
static const struct { uint16_t reg; uint8_t value; } sensor_table[] = {
 {0x0100,0x00},
 {0x36e9,0x80},
 {0x37f9,0x80},
 {0x301f,0x10},
 {0x3058,0x21},
 {0x3059,0x53},
 {0x305a,0x40},
 {0x3250,0x00},
 {0x3301,0x0c},
 {0x3304,0x50},
 {0x3305,0x00},
 {0x3306,0x50},
 {0x3307,0x04},
 {0x3308,0x0a},
 {0x3309,0x60},
 {0x330b,0xc8},
 {0x330d,0x08},
 {0x330e,0x38},
 {0x331e,0x41},
 {0x331f,0x51},
 {0x3333,0x10},
 {0x3334,0x40},
 {0x3364,0x5e},
 {0x338e,0xe2},
 {0x338f,0x80},
 {0x3390,0x08},
 {0x3391,0x18},
 {0x3392,0xb8},
 {0x3393,0x12},
 {0x3394,0x14},
 {0x3395,0x10},
 {0x3396,0x88},
 {0x3397,0x98},
 {0x3398,0xb8},
 {0x3399,0x10},
 {0x339a,0x16},
 {0x339b,0x1c},
 {0x339c,0x40},
 {0x33ac,0x0a},
 {0x33ad,0x10},
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
};
