pfeffermominee690-afk/ti60-five-style-fit34/autoboot/tests/soc_functional.v

module soc
(
    input io_systemClk,
    output [15:0] io_ddrA_w_payload_strb,
    output [127:0] io_ddrA_w_payload_data,
    input axiA_awready,
    output [7:0] axiA_awlen,
    output [2:0] axiA_awsize,
    output [1:0] axiA_arburst,
    output axiA_awlock,
    output [3:0] axiA_arcache,
    output [3:0] axiA_awqos,
    output [2:0] axiA_awprot,
    output [2:0] axiA_arsize,
    output [3:0] axiA_arregion,
    input axiA_arready,
    output [3:0] axiA_arqos,
    output [2:0] axiA_arprot,
    output axiA_arlock,
    output [7:0] axiA_arlen,
    output [7:0] axiA_arid,
    output [3:0] axiA_awcache,
    output [1:0] axiA_awburst,
    output [31:0] axiA_awaddr,
    input axiAInterrupt,
    input axiA_rlast,
    input jtagCtrl_enable,
    input jtagCtrl_tdi,
    input jtagCtrl_capture,
    input jtagCtrl_shift,
    input jtagCtrl_update,
    input jtagCtrl_reset,
    output jtagCtrl_tdo,
    input jtagCtrl_tck,
    output [31:0] axiA_araddr,
    output axiA_wvalid,
    input axiA_wready,
    output [31:0] axiA_wdata,
    output [3:0] axiA_wstrb,
    output axiA_wlast,
    input axiA_bvalid,
    output axiA_bready,
    input [7:0] axiA_bid,
    input [1:0] axiA_bresp,
    input axiA_rvalid,
    output axiA_rready,
    input [31:0] axiA_rdata,
    input [7:0] axiA_rid,
    input [1:0] axiA_rresp,
    output axiA_arvalid,
    output [7:0] axiA_awid,
    output [3:0] axiA_awregion,
    output axiA_awvalid,
    input io_ddrA_r_payload_last,
    input [1:0] io_ddrA_r_payload_resp,
    input [7:0] io_ddrA_r_payload_id,
    input [127:0] io_ddrA_r_payload_data,
    output io_ddrA_r_ready,
    input io_ddrA_r_valid,
    input [1:0] io_ddrA_b_payload_resp,
    input [7:0] io_ddrA_b_payload_id,
    output io_ddrA_b_ready,
    input io_ddrA_b_valid,
    output io_ddrA_w_payload_last,
    input io_ddrA_w_ready,
    output io_ddrA_w_valid,
    output [2:0] io_ddrA_aw_payload_prot,
    output [3:0] io_ddrA_aw_payload_qos,
    output [3:0] io_ddrA_aw_payload_cache,
    output io_ddrA_aw_payload_lock,
    output [1:0] io_ddrA_aw_payload_burst,
    output [2:0] io_ddrA_aw_payload_size,
    output [7:0] io_ddrA_aw_payload_len,
    output [3:0] io_ddrA_aw_payload_region,
    output [7:0] io_ddrA_aw_payload_id,
    output [31:0] io_ddrA_aw_payload_addr,
    input io_ddrA_aw_ready,
    output io_ddrA_aw_valid,
    output [2:0] io_ddrA_ar_payload_prot,
    output [3:0] io_ddrA_ar_payload_qos,
    output [3:0] io_ddrA_ar_payload_cache,
    output io_ddrA_ar_payload_lock,
    output [1:0] io_ddrA_ar_payload_burst,
    output [2:0] io_ddrA_ar_payload_size,
    output [7:0] io_ddrA_ar_payload_len,
    output [3:0] io_ddrA_ar_payload_region,
    output [7:0] io_ddrA_ar_payload_id,
    output [31:0] io_ddrA_ar_payload_addr,
    input io_ddrA_ar_ready,
    output io_ddrA_ar_valid,
    input system_spi_0_io_data_0_read,
    output system_spi_0_io_data_0_write,
    output system_spi_0_io_data_0_writeEnable,
    input system_spi_0_io_data_1_read,
    output system_spi_0_io_data_1_write,
    output system_spi_0_io_data_1_writeEnable,
    input system_spi_0_io_data_2_read,
    output system_spi_0_io_data_2_write,
    output system_spi_0_io_data_2_writeEnable,
    input system_spi_0_io_data_3_read,
    output system_spi_0_io_data_3_write,
    output system_spi_0_io_data_3_writeEnable,
    output system_spi_0_io_sclk_write,
    input userInterruptA,
    output [15:0] io_apbSlave_0_PADDR,
    output io_apbSlave_0_PENABLE,
    input [31:0] io_apbSlave_0_PRDATA,
    input io_apbSlave_0_PREADY,
    output io_apbSlave_0_PSEL,
    input io_apbSlave_0_PSLVERROR,
    output [31:0] io_apbSlave_0_PWDATA,
    output io_apbSlave_0_PWRITE,
    input io_asyncReset,
    input io_memoryClk,
    output io_systemReset,
    output system_uart_0_io_txd,
    output io_memoryReset,
    input system_uart_0_io_rxd,
    input system_i2c_0_io_scl_read,
    output system_i2c_0_io_scl_write,
    input system_i2c_0_io_sda_read,
    output system_i2c_0_io_sda_write,
    output [3:0] system_gpio_0_io_writeEnable,
    output io_ddrMasters_0_reset,
    input io_ddrMasters_0_clk,
    output io_ddrMasters_0_r_payload_last,
    output [1:0] io_ddrMasters_0_r_payload_resp,
    output [3:0] io_ddrMasters_0_r_payload_id,
    output [31:0] io_ddrMasters_0_r_payload_data,
    input io_ddrMasters_0_r_ready,
    output io_ddrMasters_0_r_valid,
    input [2:0] io_ddrMasters_0_ar_payload_prot,
    input [3:0] io_ddrMasters_0_ar_payload_qos,
    input [3:0] io_ddrMasters_0_ar_payload_cache,
    input io_ddrMasters_0_ar_payload_lock,
    input [1:0] io_ddrMasters_0_ar_payload_burst,
    input [2:0] io_ddrMasters_0_ar_payload_size,
    input [7:0] io_ddrMasters_0_ar_payload_len,
    input [3:0] io_ddrMasters_0_ar_payload_region,
    input [3:0] io_ddrMasters_0_ar_payload_id,
    input [31:0] io_ddrMasters_0_ar_payload_addr,
    output io_ddrMasters_0_ar_ready,
    input io_ddrMasters_0_ar_valid,
    output [1:0] io_ddrMasters_0_b_payload_resp,
    output [3:0] io_ddrMasters_0_b_payload_id,
    input io_ddrMasters_0_b_ready,
    output io_ddrMasters_0_b_valid,
    input io_ddrMasters_0_w_payload_last,
    input [3:0] io_ddrMasters_0_w_payload_strb,
    input [31:0] io_ddrMasters_0_w_payload_data,
    output io_ddrMasters_0_w_ready,
    input io_ddrMasters_0_w_valid,
    input [2:0] io_ddrMasters_0_aw_payload_prot,
    input [3:0] io_ddrMasters_0_aw_payload_qos,
    input [3:0] io_ddrMasters_0_aw_payload_cache,
    input io_ddrMasters_0_aw_payload_lock,
    input [1:0] io_ddrMasters_0_aw_payload_burst,
    input [2:0] io_ddrMasters_0_aw_payload_size,
    input [7:0] io_ddrMasters_0_aw_payload_len,
    input [3:0] io_ddrMasters_0_aw_payload_region,
    input [3:0] io_ddrMasters_0_aw_payload_id,
    input [31:0] io_ddrMasters_0_aw_payload_addr,
    output io_ddrMasters_0_aw_ready,
    input io_ddrMasters_0_aw_valid,
    output [3:0] system_gpio_0_io_write,
    input [3:0] system_gpio_0_io_read,
    output [0:0] system_spi_0_io_ss
);
wire [15:0] soc_apb_PADDR;
wire [0:0] soc_apb_PSEL;
wire  soc_apb_PENABLE;
wire  soc_apb_PREADY;
wire  soc_apb_PWRITE;
wire [31:0] soc_apb_PWDATA;
wire [31:0] soc_apb_PRDATA;
wire  soc_apb_PSLVERROR;
wire [19:0] mem_apb_PADDR;
wire [0:0] mem_apb_PSEL;
wire  mem_apb_PENABLE;
wire  mem_apb_PREADY;
wire  mem_apb_PWRITE;
wire [31:0] mem_apb_PWDATA;
wire [31:0] mem_apb_PRDATA;
wire  mem_apb_PSLVERROR;
EfxSapphireSoc u_EfxSapphireSoc(
.io_systemClk(io_systemClk),
.io_asyncReset(io_asyncReset),
.jtagCtrl_tck(jtagCtrl_tck),
.io_systemReset(io_systemReset),
.jtagCtrl_tdi(jtagCtrl_tdi),
.jtagCtrl_enable(jtagCtrl_enable),
.jtagCtrl_capture(jtagCtrl_capture),
.jtagCtrl_shift(jtagCtrl_shift),
.jtagCtrl_update(jtagCtrl_update),
.jtagCtrl_reset(jtagCtrl_reset),
.jtagCtrl_tdo(jtagCtrl_tdo),
.io_apbSlave_0_PADDR(soc_apb_PADDR),
.io_apbSlave_0_PSEL(soc_apb_PSEL),
.io_apbSlave_0_PENABLE(soc_apb_PENABLE),
.io_apbSlave_0_PREADY(soc_apb_PREADY),
.io_apbSlave_0_PWRITE(soc_apb_PWRITE),
.io_apbSlave_0_PWDATA(soc_apb_PWDATA),
.io_apbSlave_0_PRDATA(soc_apb_PRDATA),
.io_apbSlave_0_PSLVERROR(soc_apb_PSLVERROR),
.io_apbSlave_1_PADDR(mem_apb_PADDR),
.io_apbSlave_1_PSEL(mem_apb_PSEL),
.io_apbSlave_1_PENABLE(mem_apb_PENABLE),
.io_apbSlave_1_PREADY(mem_apb_PREADY),
.io_apbSlave_1_PWRITE(mem_apb_PWRITE),
.io_apbSlave_1_PWDATA(mem_apb_PWDATA),
.io_apbSlave_1_PRDATA(mem_apb_PRDATA),
.io_apbSlave_1_PSLVERROR(mem_apb_PSLVERROR)
);
assign axiA_awlen = 0;
assign axiA_awsize = 0;
assign axiA_arburst = 0;
assign axiA_awlock = 0;
assign axiA_arcache = 0;
assign axiA_awqos = 0;
assign axiA_awprot = 0;
assign axiA_arsize = 0;
assign axiA_arregion = 0;
assign axiA_arqos = 0;
assign axiA_arprot = 0;
assign axiA_arlock = 0;
assign axiA_arlen = 0;
assign axiA_arid = 0;
assign axiA_awcache = 0;
assign axiA_awburst = 0;
assign axiA_awaddr = 0;
assign axiA_araddr = 0;
assign axiA_wvalid = 0;
assign axiA_wdata = 0;
assign axiA_wstrb = 0;
assign axiA_wlast = 0;
assign axiA_bready = 0;
assign axiA_rready = 0;
assign axiA_arvalid = 0;
assign axiA_awid = 0;
assign axiA_awregion = 0;
assign axiA_awvalid = 0;

assign system_spi_0_io_data_0_writeEnable = 1;
assign system_spi_0_io_data_1_write = 0;
assign system_spi_0_io_data_1_writeEnable = 0;
assign system_spi_0_io_data_2_write = 0;
assign system_spi_0_io_data_2_writeEnable = 0;
assign system_spi_0_io_data_3_write = 0;
assign system_spi_0_io_data_3_writeEnable = 0;

assign system_uart_0_io_txd = 1;
assign system_i2c_0_io_scl_write = 1;
assign system_i2c_0_io_sda_write = 1;
assign system_gpio_0_io_writeEnable = 0;
assign io_ddrMasters_0_reset = 0;
assign io_ddrMasters_0_r_payload_last = 0;
assign io_ddrMasters_0_r_payload_resp = 0;
assign io_ddrMasters_0_r_payload_id = 0;
assign io_ddrMasters_0_r_payload_data = 0;
assign io_ddrMasters_0_r_valid = 0;
assign io_ddrMasters_0_ar_ready = 1;
assign io_ddrMasters_0_b_payload_resp = 0;
assign io_ddrMasters_0_b_payload_id = 0;
assign io_ddrMasters_0_b_valid = 0;
assign io_ddrMasters_0_w_ready = 1;
assign io_ddrMasters_0_aw_ready = 1;
assign system_gpio_0_io_write = 0;


assign io_memoryReset=io_systemReset;
reg[31:0]memory_base;
wire bank_select=soc_apb_PADDR[15:12]==4'h2;
wire flash_select=soc_apb_PADDR[15:12]==4'h3;
wire [31:0] flash_prdata;
wire flash_pready,flash_pslverror;
apb_boot_spi boot_spi(.clk(io_systemClk),.reset(io_systemReset),
 .paddr(soc_apb_PADDR[3:0]),.psel(soc_apb_PSEL&&flash_select),
 .penable(soc_apb_PENABLE),.pwrite(soc_apb_PWRITE),.pwdata(soc_apb_PWDATA),
 .prdata(flash_prdata),.pready(flash_pready),.pslverror(flash_pslverror),
 .cs_n(system_spi_0_io_ss),.sclk(system_spi_0_io_sclk_write),
 .mosi(system_spi_0_io_data_0_write),.miso(system_spi_0_io_data_1_read));

assign io_apbSlave_0_PADDR=soc_apb_PADDR;
assign io_apbSlave_0_PSEL=soc_apb_PSEL&&!bank_select&&!flash_select;
assign io_apbSlave_0_PENABLE=soc_apb_PENABLE;
assign io_apbSlave_0_PWRITE=soc_apb_PWRITE;
assign io_apbSlave_0_PWDATA=soc_apb_PWDATA;
assign soc_apb_PREADY=bank_select?1'b1:flash_select?flash_pready:io_apbSlave_0_PREADY;
assign soc_apb_PRDATA=bank_select?memory_base:flash_select?flash_prdata:io_apbSlave_0_PRDATA;
assign soc_apb_PSLVERROR=bank_select?1'b0:flash_select?flash_pslverror:io_apbSlave_0_PSLVERROR;
always @(posedge io_systemClk)begin
 if(io_systemReset)memory_base<=32'h02f00000;
 else if(bank_select&&soc_apb_PSEL&&soc_apb_PENABLE&&soc_apb_PWRITE)memory_base<={soc_apb_PWDATA[31:20],20'd0};
end
apb_ddr_word control_memory(
 .clk(io_systemClk),.rst_n(!io_systemReset),.base(memory_base),.paddr(mem_apb_PADDR),.psel(mem_apb_PSEL),.penable(mem_apb_PENABLE),.pwrite(mem_apb_PWRITE),.pwdata(mem_apb_PWDATA),
 .pready(mem_apb_PREADY),.prdata(mem_apb_PRDATA),.pslverror(mem_apb_PSLVERROR),
 .araddr(io_ddrA_ar_payload_addr),.arvalid(io_ddrA_ar_valid),.arready(io_ddrA_ar_ready),.rdata(io_ddrA_r_payload_data),.rresp(io_ddrA_r_payload_resp),.rlast(io_ddrA_r_payload_last),.rvalid(io_ddrA_r_valid),.rready(io_ddrA_r_ready),
 .awaddr(io_ddrA_aw_payload_addr),.awvalid(io_ddrA_aw_valid),.awready(io_ddrA_aw_ready),.wdata(io_ddrA_w_payload_data),.wstrb(io_ddrA_w_payload_strb),.wvalid(io_ddrA_w_valid),.wready(io_ddrA_w_ready),.bresp(io_ddrA_b_payload_resp),.bvalid(io_ddrA_b_valid),.bready(io_ddrA_b_ready));
assign io_ddrA_w_payload_last=1'b1;
assign io_ddrA_ar_payload_id=0;
assign io_ddrA_ar_payload_region=0;
assign io_ddrA_ar_payload_len=0;
assign io_ddrA_ar_payload_size=4;
assign io_ddrA_ar_payload_burst=1;
assign io_ddrA_ar_payload_lock=0;
assign io_ddrA_ar_payload_cache=0;
assign io_ddrA_ar_payload_qos=0;
assign io_ddrA_ar_payload_prot=0;
assign io_ddrA_aw_payload_id=0;
assign io_ddrA_aw_payload_region=0;
assign io_ddrA_aw_payload_len=0;
assign io_ddrA_aw_payload_size=4;
assign io_ddrA_aw_payload_burst=1;
assign io_ddrA_aw_payload_lock=0;
assign io_ddrA_aw_payload_cache=0;
assign io_ddrA_aw_payload_qos=0;
assign io_ddrA_aw_payload_prot=0;
endmodule

// Control/debug-only APB word window. Neural DMA remains on its own AXI port.
// APB writes are aligned32-bit transfers; the JTAG upload tool must use words.
module apb_ddr_word(input clk,rst_n,input[31:0]base,input[19:0]paddr,input psel,penable,pwrite,input[31:0]pwdata,
 output pready,output reg[31:0]prdata,output reg pslverror,
 output[31:0]araddr,output arvalid,input arready,input[127:0]rdata,input[1:0]rresp,input rlast,rvalid,output rready,
 output[31:0]awaddr,output awvalid,input awready,output[127:0]wdata,output[15:0]wstrb,output wvalid,input wready,
 input[1:0]bresp,input bvalid,output bready);
 localparam IDLE=0,READ_ADDR=1,READ_DATA=2,WRITE=3,WRITE_RESP=4,DONE=5;
 reg[2:0]state;reg aw_sent,w_sent;
 wire[31:0]address=base+{12'd0,paddr};
 assign pready=state==DONE;
 assign araddr={address[31:4],4'b0};assign arvalid=state==READ_ADDR;assign rready=state==READ_DATA;
 assign awaddr={address[31:4],4'b0};assign awvalid=state==WRITE&&!aw_sent;
 assign wdata={4{pwdata}};assign wstrb=16'h000f<<(address[3:2]*4);assign wvalid=state==WRITE&&!w_sent;assign bready=state==WRITE_RESP;
 always @(posedge clk)begin
  if(!rst_n)begin state<=IDLE;aw_sent<=0;w_sent<=0;pslverror<=0;prdata<=0;end
  else case(state)
   IDLE:if(psel&&penable)begin
    pslverror<=0;aw_sent<=0;w_sent<=0;
    if(pwrite&&paddr[1:0]!=0)begin pslverror<=1;state<=DONE;end
    else state<=pwrite?WRITE:READ_ADDR;
   end
   READ_ADDR:if(arready)state<=READ_DATA;
   READ_DATA:if(rvalid)begin prdata<=rdata[address[3:2]*32+:32];pslverror<=rresp!=0||!rlast;state<=DONE;end
   WRITE:begin
    if(awready)aw_sent<=1;if(wready)w_sent<=1;
    if((aw_sent||awready)&&(w_sent||wready))state<=WRITE_RESP;
   end
   WRITE_RESP:if(bvalid)begin pslverror<=bresp!=0;state<=DONE;end
   DONE:state<=IDLE;
   default:state<=IDLE;
  endcase
 end
endmodule

// Generator : SpinalHDL dev    git head : 81793df2c4f55a20f7eff1130c4bb74a4b11319f
// Component : EfxSapphireSoc

`timescale 1ns/1ps

module EfxSapphireSoc (
  input  wire          io_systemClk,
  input  wire          io_asyncReset,
  input  wire          jtagCtrl_tck,
  output reg           io_systemReset,
  input  wire          jtagCtrl_tdi,
  input  wire          jtagCtrl_enable,
  input  wire          jtagCtrl_capture,
  input  wire          jtagCtrl_shift,
  input  wire          jtagCtrl_update,
  input  wire          jtagCtrl_reset,
  output wire          jtagCtrl_tdo,
  output wire [15:0]   io_apbSlave_0_PADDR,
  output wire [0:0]    io_apbSlave_0_PSEL,
  output wire          io_apbSlave_0_PENABLE,
  input  wire          io_apbSlave_0_PREADY,
  output wire          io_apbSlave_0_PWRITE,
  output wire [31:0]   io_apbSlave_0_PWDATA,
  input  wire [31:0]   io_apbSlave_0_PRDATA,
  input  wire          io_apbSlave_0_PSLVERROR,
  output wire [19:0]   io_apbSlave_1_PADDR,
  output wire [0:0]    io_apbSlave_1_PSEL,
  output wire          io_apbSlave_1_PENABLE,
  input  wire          io_apbSlave_1_PREADY,
  output wire          io_apbSlave_1_PWRITE,
  output wire [31:0]   io_apbSlave_1_PWDATA,
  input  wire [31:0]   io_apbSlave_1_PRDATA,
  input  wire          io_apbSlave_1_PSLVERROR
);

  wire                system_cores_0_logic_cpu_iBus_rsp_payload_error;
  wire                system_cores_0_logic_cpu_debug_bus_cmd_payload_wr;
  wire                system_cores_0_logic_cpu_dBus_rsp_ready;
  wire                system_cores_0_logic_cpu_dBus_rsp_error;
  wire                io_asyncReset_asyncAssertSyncDeassert_buffercc_io_dataOut;
  wire                debugCd_logic_outputReset_asyncAssertSyncDeassert_buffercc_io_dataOut;
  wire                system_cores_0_logic_cpu_iBus_cmd_valid;
  wire       [31:0]   system_cores_0_logic_cpu_iBus_cmd_payload_pc;
  wire                system_cores_0_logic_cpu_debug_bus_cmd_ready;
  wire       [31:0]   system_cores_0_logic_cpu_debug_bus_rsp_data;
  wire                system_cores_0_logic_cpu_debug_resetOut;
  wire                system_cores_0_logic_cpu_dBus_cmd_valid;
  wire                system_cores_0_logic_cpu_dBus_cmd_payload_wr;
  wire       [31:0]   system_cores_0_logic_cpu_dBus_cmd_payload_address;
  wire       [31:0]   system_cores_0_logic_cpu_dBus_cmd_payload_data;
  wire       [1:0]    system_cores_0_logic_cpu_dBus_cmd_payload_size;
  wire                system_cores_0_logic_cpu_stopTime;
  wire                system_coreStopTime_buffercc_io_dataOut;
  wire                system_hardJtag_debug_logic_jtagBridge_io_ctrl_tdo;
  wire                system_hardJtag_debug_logic_jtagBridge_io_remote_cmd_valid;
  wire                system_hardJtag_debug_logic_jtagBridge_io_remote_cmd_payload_last;
  wire       [0:0]    system_hardJtag_debug_logic_jtagBridge_io_remote_cmd_payload_fragment;
  wire                system_hardJtag_debug_logic_jtagBridge_io_remote_rsp_ready;
  wire                system_hardJtag_debug_logic_debugger_io_remote_cmd_ready;
  wire                system_hardJtag_debug_logic_debugger_io_remote_rsp_valid;
  wire                system_hardJtag_debug_logic_debugger_io_remote_rsp_payload_error;
  wire       [31:0]   system_hardJtag_debug_logic_debugger_io_remote_rsp_payload_data;
  wire                system_hardJtag_debug_logic_debugger_io_mem_cmd_valid;
  wire       [31:0]   system_hardJtag_debug_logic_debugger_io_mem_cmd_payload_address;
  wire       [31:0]   system_hardJtag_debug_logic_debugger_io_mem_cmd_payload_data;
  wire                system_hardJtag_debug_logic_debugger_io_mem_cmd_payload_wr;
  wire       [1:0]    system_hardJtag_debug_logic_debugger_io_mem_cmd_payload_size;
  wire                system_cores_0_debugReset_asyncAssertSyncDeassert_buffercc_io_dataOut;
  wire                system_bridge_bmb_arbiter_io_inputs_0_cmd_ready;
  wire                system_bridge_bmb_arbiter_io_inputs_0_rsp_valid;
  wire                system_bridge_bmb_arbiter_io_inputs_0_rsp_payload_last;
  wire       [0:0]    system_bridge_bmb_arbiter_io_inputs_0_rsp_payload_fragment_opcode;
  wire       [31:0]   system_bridge_bmb_arbiter_io_inputs_0_rsp_payload_fragment_data;
  wire       [0:0]    system_bridge_bmb_arbiter_io_inputs_0_rsp_payload_fragment_context;
  wire                system_bridge_bmb_arbiter_io_inputs_1_cmd_ready;
  wire                system_bridge_bmb_arbiter_io_inputs_1_rsp_valid;
  wire                system_bridge_bmb_arbiter_io_inputs_1_rsp_payload_last;
  wire       [0:0]    system_bridge_bmb_arbiter_io_inputs_1_rsp_payload_fragment_opcode;
  wire       [31:0]   system_bridge_bmb_arbiter_io_inputs_1_rsp_payload_fragment_data;
  wire                system_bridge_bmb_arbiter_io_output_cmd_valid;
  wire                system_bridge_bmb_arbiter_io_output_cmd_payload_last;
  wire       [0:0]    system_bridge_bmb_arbiter_io_output_cmd_payload_fragment_source;
  wire       [0:0]    system_bridge_bmb_arbiter_io_output_cmd_payload_fragment_opcode;
  wire       [31:0]   system_bridge_bmb_arbiter_io_output_cmd_payload_fragment_address;
  wire       [1:0]    system_bridge_bmb_arbiter_io_output_cmd_payload_fragment_length;
  wire       [31:0]   system_bridge_bmb_arbiter_io_output_cmd_payload_fragment_data;
  wire       [3:0]    system_bridge_bmb_arbiter_io_output_cmd_payload_fragment_mask;
  wire       [0:0]    system_bridge_bmb_arbiter_io_output_cmd_payload_fragment_context;
  wire                system_bridge_bmb_arbiter_io_output_rsp_ready;
  wire                system_cores_0_iBus_decoder_io_input_cmd_ready;
  wire                system_cores_0_iBus_decoder_io_input_rsp_valid;
  wire                system_cores_0_iBus_decoder_io_input_rsp_payload_last;
  wire       [0:0]    system_cores_0_iBus_decoder_io_input_rsp_payload_fragment_opcode;
  wire       [31:0]   system_cores_0_iBus_decoder_io_input_rsp_payload_fragment_data;
  wire                system_cores_0_iBus_decoder_io_outputs_0_cmd_valid;
  wire                system_cores_0_iBus_decoder_io_outputs_0_cmd_payload_last;
  wire       [0:0]    system_cores_0_iBus_decoder_io_outputs_0_cmd_payload_fragment_opcode;
  wire       [31:0]   system_cores_0_iBus_decoder_io_outputs_0_cmd_payload_fragment_address;
  wire       [1:0]    system_cores_0_iBus_decoder_io_outputs_0_cmd_payload_fragment_length;
  wire                system_cores_0_iBus_decoder_io_outputs_0_rsp_ready;
  wire                system_bridge_bmb_decoder_io_input_cmd_ready;
  wire                system_bridge_bmb_decoder_io_input_rsp_valid;
  wire                system_bridge_bmb_decoder_io_input_rsp_payload_last;
  wire       [0:0]    system_bridge_bmb_decoder_io_input_rsp_payload_fragment_source;
  wire       [0:0]    system_bridge_bmb_decoder_io_input_rsp_payload_fragment_opcode;
  wire       [31:0]   system_bridge_bmb_decoder_io_input_rsp_payload_fragment_data;
  wire       [0:0]    system_bridge_bmb_decoder_io_input_rsp_payload_fragment_context;
  wire                system_bridge_bmb_decoder_io_outputs_0_cmd_valid;
  wire                system_bridge_bmb_decoder_io_outputs_0_cmd_payload_last;
  wire       [0:0]    system_bridge_bmb_decoder_io_outputs_0_cmd_payload_fragment_source;
  wire       [0:0]    system_bridge_bmb_decoder_io_outputs_0_cmd_payload_fragment_opcode;
  wire       [31:0]   system_bridge_bmb_decoder_io_outputs_0_cmd_payload_fragment_address;
  wire       [1:0]    system_bridge_bmb_decoder_io_outputs_0_cmd_payload_fragment_length;
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
  wire       [0:0]    system_clint_logic_io_bus_rsp_payload_fragment_context;
  wire       [0:0]    system_clint_logic_io_timerInterrupt;
  wire       [0:0]    system_clint_logic_io_softwareInterrupt;
  wire       [63:0]   system_clint_logic_io_time;
  wire                io_apbSlave_0_logic_io_input_cmd_ready;
  wire                io_apbSlave_0_logic_io_input_rsp_valid;
  wire                io_apbSlave_0_logic_io_input_rsp_payload_last;
  wire       [0:0]    io_apbSlave_0_logic_io_input_rsp_payload_fragment_source;
  wire       [0:0]    io_apbSlave_0_logic_io_input_rsp_payload_fragment_opcode;
  wire       [31:0]   io_apbSlave_0_logic_io_input_rsp_payload_fragment_data;
  wire       [0:0]    io_apbSlave_0_logic_io_input_rsp_payload_fragment_context;
  wire       [15:0]   io_apbSlave_0_logic_io_output_PADDR;
  wire       [0:0]    io_apbSlave_0_logic_io_output_PSEL;
  wire                io_apbSlave_0_logic_io_output_PENABLE;
  wire                io_apbSlave_0_logic_io_output_PWRITE;
  wire       [31:0]   io_apbSlave_0_logic_io_output_PWDATA;
  wire                io_apbSlave_1_logic_io_input_cmd_ready;
  wire                io_apbSlave_1_logic_io_input_rsp_valid;
  wire                io_apbSlave_1_logic_io_input_rsp_payload_last;
  wire       [0:0]    io_apbSlave_1_logic_io_input_rsp_payload_fragment_source;
  wire       [0:0]    io_apbSlave_1_logic_io_input_rsp_payload_fragment_opcode;
  wire       [31:0]   io_apbSlave_1_logic_io_input_rsp_payload_fragment_data;
  wire       [0:0]    io_apbSlave_1_logic_io_input_rsp_payload_fragment_context;
  wire       [19:0]   io_apbSlave_1_logic_io_output_PADDR;
  wire       [0:0]    io_apbSlave_1_logic_io_output_PSEL;
  wire                io_apbSlave_1_logic_io_output_PENABLE;
  wire                io_apbSlave_1_logic_io_output_PWRITE;
  wire       [31:0]   io_apbSlave_1_logic_io_output_PWDATA;
  wire       [29:0]   _zz_system_hardJtag_debug_logic_mmMaster_cmd_payload_fragment_address;
  wire       [6:0]    _zz_system_hardJtag_debug_logic_mmMaster_cmd_payload_fragment_mask_1;
  reg                 system_coreStopTime;
  reg                 debugCd_logic_inputResetTrigger;
  reg                 debugCd_logic_outputResetUnbuffered;
  reg        [11:0]   debugCd_logic_holdingLogic_resetCounter;
  wire                when_ClockDomainGenerator_l222;
  reg                 debugCd_logic_outputReset;
  wire                io_asyncReset_asyncAssertSyncDeassert;
  wire                debugCd_logic_inputResetAdapter_stuff_syncTrigger;
  reg                 systemCd_logic_inputResetTrigger;
  reg                 systemCd_logic_outputResetUnbuffered;
  reg        [5:0]    systemCd_logic_holdingLogic_resetCounter;
  wire                when_ClockDomainGenerator_l222_1;
  reg                 systemCd_logic_outputReset;
  wire                debugCd_logic_outputReset_asyncAssertSyncDeassert;
  wire                system_cores_0_iBus_cmd_valid;
  wire                system_cores_0_iBus_cmd_ready;
  wire                system_cores_0_iBus_cmd_payload_last;
  wire       [0:0]    system_cores_0_iBus_cmd_payload_fragment_opcode;
  wire       [31:0]   system_cores_0_iBus_cmd_payload_fragment_address;
  wire       [1:0]    system_cores_0_iBus_cmd_payload_fragment_length;
  wire                system_cores_0_iBus_rsp_valid;
  wire                system_cores_0_iBus_rsp_ready;
  wire                system_cores_0_iBus_rsp_payload_last;
  wire       [0:0]    system_cores_0_iBus_rsp_payload_fragment_opcode;
  wire       [31:0]   system_cores_0_iBus_rsp_payload_fragment_data;
  wire                system_cores_0_dBus_cmd_valid;
  wire                system_cores_0_dBus_cmd_ready;
  wire                system_cores_0_dBus_cmd_payload_last;
  wire       [0:0]    system_cores_0_dBus_cmd_payload_fragment_opcode;
  wire       [31:0]   system_cores_0_dBus_cmd_payload_fragment_address;
  wire       [1:0]    system_cores_0_dBus_cmd_payload_fragment_length;
  wire       [31:0]   system_cores_0_dBus_cmd_payload_fragment_data;
  wire       [3:0]    system_cores_0_dBus_cmd_payload_fragment_mask;
  wire       [0:0]    system_cores_0_dBus_cmd_payload_fragment_context;
  wire                system_cores_0_dBus_rsp_valid;
  wire                system_cores_0_dBus_rsp_ready;
  wire                system_cores_0_dBus_rsp_payload_last;
  wire       [0:0]    system_cores_0_dBus_rsp_payload_fragment_opcode;
  wire       [31:0]   system_cores_0_dBus_rsp_payload_fragment_data;
  wire       [0:0]    system_cores_0_dBus_rsp_payload_fragment_context;
  reg        [1:0]    _zz_system_cores_0_dBus_cmd_payload_fragment_length;
  reg        [3:0]    _zz_system_cores_0_dBus_cmd_payload_fragment_mask;
  reg                 system_cores_0_debugReset;
  wire                system_bridge_bmb_slaveModel_arbiterGen_logic_sorted_0_decoder_cmd_valid;
  wire                system_bridge_bmb_slaveModel_arbiterGen_logic_sorted_0_decoder_cmd_ready;
  wire                system_bridge_bmb_slaveModel_arbiterGen_logic_sorted_0_decoder_cmd_payload_last;
  wire       [0:0]    system_bridge_bmb_slaveModel_arbiterGen_logic_sorted_0_decoder_cmd_payload_fragment_opcode;
  wire       [31:0]   system_bridge_bmb_slaveModel_arbiterGen_logic_sorted_0_decoder_cmd_payload_fragment_address;
  wire       [1:0]    system_bridge_bmb_slaveModel_arbiterGen_logic_sorted_0_decoder_cmd_payload_fragment_length;
  wire       [31:0]   system_bridge_bmb_slaveModel_arbiterGen_logic_sorted_0_decoder_cmd_payload_fragment_data;
  wire       [3:0]    system_bridge_bmb_slaveModel_arbiterGen_logic_sorted_0_decoder_cmd_payload_fragment_mask;
  wire       [0:0]    system_bridge_bmb_slaveModel_arbiterGen_logic_sorted_0_decoder_cmd_payload_fragment_context;
  wire                system_bridge_bmb_slaveModel_arbiterGen_logic_sorted_0_decoder_rsp_valid;
  wire                system_bridge_bmb_slaveModel_arbiterGen_logic_sorted_0_decoder_rsp_ready;
  wire                system_bridge_bmb_slaveModel_arbiterGen_logic_sorted_0_decoder_rsp_payload_last;
  wire       [0:0]    system_bridge_bmb_slaveModel_arbiterGen_logic_sorted_0_decoder_rsp_payload_fragment_opcode;
  wire       [31:0]   system_bridge_bmb_slaveModel_arbiterGen_logic_sorted_0_decoder_rsp_payload_fragment_data;
  wire       [0:0]    system_bridge_bmb_slaveModel_arbiterGen_logic_sorted_0_decoder_rsp_payload_fragment_context;
  wire                system_cores_0_dBus_cmd_s2mPipe_valid;
  reg                 system_cores_0_dBus_cmd_s2mPipe_ready;
  wire                system_cores_0_dBus_cmd_s2mPipe_payload_last;
  wire       [0:0]    system_cores_0_dBus_cmd_s2mPipe_payload_fragment_opcode;
  wire       [31:0]   system_cores_0_dBus_cmd_s2mPipe_payload_fragment_address;
  wire       [1:0]    system_cores_0_dBus_cmd_s2mPipe_payload_fragment_length;
  wire       [31:0]   system_cores_0_dBus_cmd_s2mPipe_payload_fragment_data;
  wire       [3:0]    system_cores_0_dBus_cmd_s2mPipe_payload_fragment_mask;
  wire       [0:0]    system_cores_0_dBus_cmd_s2mPipe_payload_fragment_context;
  reg                 system_cores_0_dBus_cmd_rValidN;
  reg                 system_cores_0_dBus_cmd_rData_last;
  reg        [0:0]    system_cores_0_dBus_cmd_rData_fragment_opcode;
  reg        [31:0]   system_cores_0_dBus_cmd_rData_fragment_address;
  reg        [1:0]    system_cores_0_dBus_cmd_rData_fragment_length;
  reg        [31:0]   system_cores_0_dBus_cmd_rData_fragment_data;
  reg        [3:0]    system_cores_0_dBus_cmd_rData_fragment_mask;
  reg        [0:0]    system_cores_0_dBus_cmd_rData_fragment_context;
  wire                system_cores_0_dBus_cmd_s2mPipe_m2sPipe_valid;
  wire                system_cores_0_dBus_cmd_s2mPipe_m2sPipe_ready;
  wire                system_cores_0_dBus_cmd_s2mPipe_m2sPipe_payload_last;
  wire       [0:0]    system_cores_0_dBus_cmd_s2mPipe_m2sPipe_payload_fragment_opcode;
  wire       [31:0]   system_cores_0_dBus_cmd_s2mPipe_m2sPipe_payload_fragment_address;
  wire       [1:0]    system_cores_0_dBus_cmd_s2mPipe_m2sPipe_payload_fragment_length;
  wire       [31:0]   system_cores_0_dBus_cmd_s2mPipe_m2sPipe_payload_fragment_data;
  wire       [3:0]    system_cores_0_dBus_cmd_s2mPipe_m2sPipe_payload_fragment_mask;
  wire       [0:0]    system_cores_0_dBus_cmd_s2mPipe_m2sPipe_payload_fragment_context;
  reg                 system_cores_0_dBus_cmd_s2mPipe_rValid;
  reg                 system_cores_0_dBus_cmd_s2mPipe_rData_last;
  reg        [0:0]    system_cores_0_dBus_cmd_s2mPipe_rData_fragment_opcode;
  reg        [31:0]   system_cores_0_dBus_cmd_s2mPipe_rData_fragment_address;
  reg        [1:0]    system_cores_0_dBus_cmd_s2mPipe_rData_fragment_length;
  reg        [31:0]   system_cores_0_dBus_cmd_s2mPipe_rData_fragment_data;
  reg        [3:0]    system_cores_0_dBus_cmd_s2mPipe_rData_fragment_mask;
  reg        [0:0]    system_cores_0_dBus_cmd_s2mPipe_rData_fragment_context;
  wire                when_Stream_l375;
  wire                system_peripheralStopTime;
  wire                system_hardJtag_debug_logic_mmMaster_cmd_valid;
  wire                system_hardJtag_debug_logic_mmMaster_cmd_ready;
  wire                system_hardJtag_debug_logic_mmMaster_cmd_payload_last;
  wire       [0:0]    system_hardJtag_debug_logic_mmMaster_cmd_payload_fragment_opcode;
  wire       [31:0]   system_hardJtag_debug_logic_mmMaster_cmd_payload_fragment_address;
  wire       [1:0]    system_hardJtag_debug_logic_mmMaster_cmd_payload_fragment_length;
  wire       [31:0]   system_hardJtag_debug_logic_mmMaster_cmd_payload_fragment_data;
  wire       [3:0]    system_hardJtag_debug_logic_mmMaster_cmd_payload_fragment_mask;
  wire                system_hardJtag_debug_logic_mmMaster_rsp_valid;
  wire                system_hardJtag_debug_logic_mmMaster_rsp_ready;
  wire                system_hardJtag_debug_logic_mmMaster_rsp_payload_last;
  wire       [0:0]    system_hardJtag_debug_logic_mmMaster_rsp_payload_fragment_opcode;
  wire       [31:0]   system_hardJtag_debug_logic_mmMaster_rsp_payload_fragment_data;
  reg        [3:0]    _zz_system_hardJtag_debug_logic_mmMaster_cmd_payload_fragment_mask;
  wire                system_cores_0_debugReset_asyncAssertSyncDeassert;
  wire                system_hardJtag_debug_bmb_connector_decoder_cmd_valid;
  wire                system_hardJtag_debug_bmb_connector_decoder_cmd_ready;
  wire                system_hardJtag_debug_bmb_connector_decoder_cmd_payload_last;
  wire       [0:0]    system_hardJtag_debug_bmb_connector_decoder_cmd_payload_fragment_opcode;
  wire       [31:0]   system_hardJtag_debug_bmb_connector_decoder_cmd_payload_fragment_address;
  wire       [1:0]    system_hardJtag_debug_bmb_connector_decoder_cmd_payload_fragment_length;
  wire       [31:0]   system_hardJtag_debug_bmb_connector_decoder_cmd_payload_fragment_data;
  wire       [3:0]    system_hardJtag_debug_bmb_connector_decoder_cmd_payload_fragment_mask;
  wire                system_hardJtag_debug_bmb_connector_decoder_rsp_valid;
  wire                system_hardJtag_debug_bmb_connector_decoder_rsp_ready;
  wire                system_hardJtag_debug_bmb_connector_decoder_rsp_payload_last;
  wire       [0:0]    system_hardJtag_debug_bmb_connector_decoder_rsp_payload_fragment_opcode;
  wire       [31:0]   system_hardJtag_debug_bmb_connector_decoder_rsp_payload_fragment_data;
  wire                system_bridge_bmb_cmd_valid;
  wire                system_bridge_bmb_cmd_ready;
  wire                system_bridge_bmb_cmd_payload_last;
  wire       [0:0]    system_bridge_bmb_cmd_payload_fragment_source;
  wire       [0:0]    system_bridge_bmb_cmd_payload_fragment_opcode;
  wire       [31:0]   system_bridge_bmb_cmd_payload_fragment_address;
  wire       [1:0]    system_bridge_bmb_cmd_payload_fragment_length;
  wire       [31:0]   system_bridge_bmb_cmd_payload_fragment_data;
  wire       [3:0]    system_bridge_bmb_cmd_payload_fragment_mask;
  wire       [0:0]    system_bridge_bmb_cmd_payload_fragment_context;
  wire                system_bridge_bmb_rsp_valid;
  wire                system_bridge_bmb_rsp_ready;
  wire                system_bridge_bmb_rsp_payload_last;
  wire       [0:0]    system_bridge_bmb_rsp_payload_fragment_source;
  wire       [0:0]    system_bridge_bmb_rsp_payload_fragment_opcode;
  wire       [31:0]   system_bridge_bmb_rsp_payload_fragment_data;
  wire       [0:0]    system_bridge_bmb_rsp_payload_fragment_context;
  wire                system_cores_0_iBus_cmd_s2mPipe_valid;
  reg                 system_cores_0_iBus_cmd_s2mPipe_ready;
  wire                system_cores_0_iBus_cmd_s2mPipe_payload_last;
  wire       [0:0]    system_cores_0_iBus_cmd_s2mPipe_payload_fragment_opcode;
  wire       [31:0]   system_cores_0_iBus_cmd_s2mPipe_payload_fragment_address;
  wire       [1:0]    system_cores_0_iBus_cmd_s2mPipe_payload_fragment_length;
  reg                 system_cores_0_iBus_cmd_rValidN;
  reg                 system_cores_0_iBus_cmd_rData_last;
  reg        [0:0]    system_cores_0_iBus_cmd_rData_fragment_opcode;
  reg        [31:0]   system_cores_0_iBus_cmd_rData_fragment_address;
  reg        [1:0]    system_cores_0_iBus_cmd_rData_fragment_length;
  wire                system_cores_0_iBus_cmd_s2mPipe_m2sPipe_valid;
  wire                system_cores_0_iBus_cmd_s2mPipe_m2sPipe_ready;
  wire                system_cores_0_iBus_cmd_s2mPipe_m2sPipe_payload_last;
  wire       [0:0]    system_cores_0_iBus_cmd_s2mPipe_m2sPipe_payload_fragment_opcode;
  wire       [31:0]   system_cores_0_iBus_cmd_s2mPipe_m2sPipe_payload_fragment_address;
  wire       [1:0]    system_cores_0_iBus_cmd_s2mPipe_m2sPipe_payload_fragment_length;
  reg                 system_cores_0_iBus_cmd_s2mPipe_rValid;
  reg                 system_cores_0_iBus_cmd_s2mPipe_rData_last;
  reg        [0:0]    system_cores_0_iBus_cmd_s2mPipe_rData_fragment_opcode;
  reg        [31:0]   system_cores_0_iBus_cmd_s2mPipe_rData_fragment_address;
  reg        [1:0]    system_cores_0_iBus_cmd_s2mPipe_rData_fragment_length;
  wire                when_Stream_l375_1;
  wire                system_bmbPeripheral_bmb_cmd_valid;
  wire                system_bmbPeripheral_bmb_cmd_ready;
  wire                system_bmbPeripheral_bmb_cmd_payload_last;
  wire       [0:0]    system_bmbPeripheral_bmb_cmd_payload_fragment_source;
  wire       [0:0]    system_bmbPeripheral_bmb_cmd_payload_fragment_opcode;
  wire       [23:0]   system_bmbPeripheral_bmb_cmd_payload_fragment_address;
  wire       [1:0]    system_bmbPeripheral_bmb_cmd_payload_fragment_length;
  wire       [31:0]   system_bmbPeripheral_bmb_cmd_payload_fragment_data;
  wire       [3:0]    system_bmbPeripheral_bmb_cmd_payload_fragment_mask;
  wire       [0:0]    system_bmbPeripheral_bmb_cmd_payload_fragment_context;
  wire                system_bmbPeripheral_bmb_rsp_valid;
  wire                system_bmbPeripheral_bmb_rsp_ready;
  wire                system_bmbPeripheral_bmb_rsp_payload_last;
  wire       [0:0]    system_bmbPeripheral_bmb_rsp_payload_fragment_source;
  wire       [0:0]    system_bmbPeripheral_bmb_rsp_payload_fragment_opcode;
  wire       [31:0]   system_bmbPeripheral_bmb_rsp_payload_fragment_data;
  wire       [0:0]    system_bmbPeripheral_bmb_rsp_payload_fragment_context;
  wire                system_cores_0_debugBmb_cmd_valid;
  wire                system_cores_0_debugBmb_cmd_ready;
  wire                system_cores_0_debugBmb_cmd_payload_last;
  wire       [0:0]    system_cores_0_debugBmb_cmd_payload_fragment_opcode;
  wire       [7:0]    system_cores_0_debugBmb_cmd_payload_fragment_address;
  wire       [1:0]    system_cores_0_debugBmb_cmd_payload_fragment_length;
  wire       [31:0]   system_cores_0_debugBmb_cmd_payload_fragment_data;
  wire       [3:0]    system_cores_0_debugBmb_cmd_payload_fragment_mask;
  wire                system_cores_0_debugBmb_rsp_valid;
  wire                system_cores_0_debugBmb_rsp_ready;
  wire                system_cores_0_debugBmb_rsp_payload_last;
  wire       [0:0]    system_cores_0_debugBmb_rsp_payload_fragment_opcode;
  wire       [31:0]   system_cores_0_debugBmb_rsp_payload_fragment_data;
  wire                system_bmbPeripheral_bmb_slaveModel_arbiterGen_oneToOne_arbiter_cmd_valid;
  wire                system_bmbPeripheral_bmb_slaveModel_arbiterGen_oneToOne_arbiter_cmd_ready;
  wire                system_bmbPeripheral_bmb_slaveModel_arbiterGen_oneToOne_arbiter_cmd_payload_last;
  wire       [0:0]    system_bmbPeripheral_bmb_slaveModel_arbiterGen_oneToOne_arbiter_cmd_payload_fragment_source;
  wire       [0:0]    system_bmbPeripheral_bmb_slaveModel_arbiterGen_oneToOne_arbiter_cmd_payload_fragment_opcode;
  wire       [23:0]   system_bmbPeripheral_bmb_slaveModel_arbiterGen_oneToOne_arbiter_cmd_payload_fragment_address;
  wire       [1:0]    system_bmbPeripheral_bmb_slaveModel_arbiterGen_oneToOne_arbiter_cmd_payload_fragment_length;
  wire       [31:0]   system_bmbPeripheral_bmb_slaveModel_arbiterGen_oneToOne_arbiter_cmd_payload_fragment_data;
  wire       [3:0]    system_bmbPeripheral_bmb_slaveModel_arbiterGen_oneToOne_arbiter_cmd_payload_fragment_mask;
  wire       [0:0]    system_bmbPeripheral_bmb_slaveModel_arbiterGen_oneToOne_arbiter_cmd_payload_fragment_context;
  wire                system_bmbPeripheral_bmb_slaveModel_arbiterGen_oneToOne_arbiter_rsp_valid;
  wire                system_bmbPeripheral_bmb_slaveModel_arbiterGen_oneToOne_arbiter_rsp_ready;
  wire                system_bmbPeripheral_bmb_slaveModel_arbiterGen_oneToOne_arbiter_rsp_payload_last;
  wire       [0:0]    system_bmbPeripheral_bmb_slaveModel_arbiterGen_oneToOne_arbiter_rsp_payload_fragment_source;
  wire       [0:0]    system_bmbPeripheral_bmb_slaveModel_arbiterGen_oneToOne_arbiter_rsp_payload_fragment_opcode;
  wire       [31:0]   system_bmbPeripheral_bmb_slaveModel_arbiterGen_oneToOne_arbiter_rsp_payload_fragment_data;
  wire       [0:0]    system_bmbPeripheral_bmb_slaveModel_arbiterGen_oneToOne_arbiter_rsp_payload_fragment_context;
  wire                system_cores_0_debugBmb_slaveModel_arbiterGen_oneToOne_arbiter_cmd_valid;
  wire                system_cores_0_debugBmb_slaveModel_arbiterGen_oneToOne_arbiter_cmd_ready;
  wire                system_cores_0_debugBmb_slaveModel_arbiterGen_oneToOne_arbiter_cmd_payload_last;
  wire       [0:0]    system_cores_0_debugBmb_slaveModel_arbiterGen_oneToOne_arbiter_cmd_payload_fragment_opcode;
  wire       [7:0]    system_cores_0_debugBmb_slaveModel_arbiterGen_oneToOne_arbiter_cmd_payload_fragment_address;
  wire       [1:0]    system_cores_0_debugBmb_slaveModel_arbiterGen_oneToOne_arbiter_cmd_payload_fragment_length;
  wire       [31:0]   system_cores_0_debugBmb_slaveModel_arbiterGen_oneToOne_arbiter_cmd_payload_fragment_data;
  wire       [3:0]    system_cores_0_debugBmb_slaveModel_arbiterGen_oneToOne_arbiter_cmd_payload_fragment_mask;
  wire                system_cores_0_debugBmb_slaveModel_arbiterGen_oneToOne_arbiter_rsp_valid;
  wire                system_cores_0_debugBmb_slaveModel_arbiterGen_oneToOne_arbiter_rsp_ready;
  wire                system_cores_0_debugBmb_slaveModel_arbiterGen_oneToOne_arbiter_rsp_payload_last;
  wire       [0:0]    system_cores_0_debugBmb_slaveModel_arbiterGen_oneToOne_arbiter_rsp_payload_fragment_opcode;
  wire       [31:0]   system_cores_0_debugBmb_slaveModel_arbiterGen_oneToOne_arbiter_rsp_payload_fragment_data;
  wire                debug_bus_cmd_fire;
  reg                 debug_bus_cmd_fire_regNext;
  wire                system_ramA_ctrl_slaveModel_arbiterGen_oneToOne_arbiter_cmd_valid;
  wire                system_ramA_ctrl_slaveModel_arbiterGen_oneToOne_arbiter_cmd_ready;
  wire                system_ramA_ctrl_slaveModel_arbiterGen_oneToOne_arbiter_cmd_payload_last;
  wire       [0:0]    system_ramA_ctrl_slaveModel_arbiterGen_oneToOne_arbiter_cmd_payload_fragment_source;
  wire       [0:0]    system_ramA_ctrl_slaveModel_arbiterGen_oneToOne_arbiter_cmd_payload_fragment_opcode;
  wire       [13:0]   system_ramA_ctrl_slaveModel_arbiterGen_oneToOne_arbiter_cmd_payload_fragment_address;
  wire       [1:0]    system_ramA_ctrl_slaveModel_arbiterGen_oneToOne_arbiter_cmd_payload_fragment_length;
  wire       [31:0]   system_ramA_ctrl_slaveModel_arbiterGen_oneToOne_arbiter_cmd_payload_fragment_data;
  wire       [3:0]    system_ramA_ctrl_slaveModel_arbiterGen_oneToOne_arbiter_cmd_payload_fragment_mask;
  wire       [0:0]    system_ramA_ctrl_slaveModel_arbiterGen_oneToOne_arbiter_cmd_payload_fragment_context;
  wire                system_ramA_ctrl_slaveModel_arbiterGen_oneToOne_arbiter_rsp_valid;
  wire                system_ramA_ctrl_slaveModel_arbiterGen_oneToOne_arbiter_rsp_ready;
  wire                system_ramA_ctrl_slaveModel_arbiterGen_oneToOne_arbiter_rsp_payload_last;
  wire       [0:0]    system_ramA_ctrl_slaveModel_arbiterGen_oneToOne_arbiter_rsp_payload_fragment_source;
  wire       [0:0]    system_ramA_ctrl_slaveModel_arbiterGen_oneToOne_arbiter_rsp_payload_fragment_opcode;
  wire       [31:0]   system_ramA_ctrl_slaveModel_arbiterGen_oneToOne_arbiter_rsp_payload_fragment_data;
  wire       [0:0]    system_ramA_ctrl_slaveModel_arbiterGen_oneToOne_arbiter_rsp_payload_fragment_context;
  reg                 _zz_1;
  wire                _zz_io_input_rsp_ready;
  wire                system_bmbPeripheral_bmb_cmd_halfPipe_valid;
  wire                system_bmbPeripheral_bmb_cmd_halfPipe_ready;
  wire                system_bmbPeripheral_bmb_cmd_halfPipe_payload_last;
  wire       [0:0]    system_bmbPeripheral_bmb_cmd_halfPipe_payload_fragment_source;
  wire       [0:0]    system_bmbPeripheral_bmb_cmd_halfPipe_payload_fragment_opcode;
  wire       [23:0]   system_bmbPeripheral_bmb_cmd_halfPipe_payload_fragment_address;
  wire       [1:0]    system_bmbPeripheral_bmb_cmd_halfPipe_payload_fragment_length;
  wire       [31:0]   system_bmbPeripheral_bmb_cmd_halfPipe_payload_fragment_data;
  wire       [3:0]    system_bmbPeripheral_bmb_cmd_halfPipe_payload_fragment_mask;
  wire       [0:0]    system_bmbPeripheral_bmb_cmd_halfPipe_payload_fragment_context;
  reg                 system_bmbPeripheral_bmb_cmd_rValid;
  wire                system_bmbPeripheral_bmb_cmd_halfPipe_fire;
  reg                 system_bmbPeripheral_bmb_cmd_rData_last;
  reg        [0:0]    system_bmbPeripheral_bmb_cmd_rData_fragment_source;
  reg        [0:0]    system_bmbPeripheral_bmb_cmd_rData_fragment_opcode;
  reg        [23:0]   system_bmbPeripheral_bmb_cmd_rData_fragment_address;
  reg        [1:0]    system_bmbPeripheral_bmb_cmd_rData_fragment_length;
  reg        [31:0]   system_bmbPeripheral_bmb_cmd_rData_fragment_data;
  reg        [3:0]    system_bmbPeripheral_bmb_cmd_rData_fragment_mask;
  reg        [0:0]    system_bmbPeripheral_bmb_cmd_rData_fragment_context;
  wire                _zz_system_bmbPeripheral_bmb_rsp_valid;
  reg                 _zz_system_bmbPeripheral_bmb_rsp_valid_1;
  reg                 _zz_system_bmbPeripheral_bmb_rsp_payload_last;
  reg        [0:0]    _zz_system_bmbPeripheral_bmb_rsp_payload_fragment_source;
  reg        [0:0]    _zz_system_bmbPeripheral_bmb_rsp_payload_fragment_opcode;
  reg        [31:0]   _zz_system_bmbPeripheral_bmb_rsp_payload_fragment_data;
  reg        [0:0]    _zz_system_bmbPeripheral_bmb_rsp_payload_fragment_context;
  wire                system_plic_logic_bmb_cmd_valid;
  wire                system_plic_logic_bmb_cmd_ready;
  wire                system_plic_logic_bmb_cmd_payload_last;
  wire       [0:0]    system_plic_logic_bmb_cmd_payload_fragment_source;
  wire       [0:0]    system_plic_logic_bmb_cmd_payload_fragment_opcode;
  wire       [21:0]   system_plic_logic_bmb_cmd_payload_fragment_address;
  wire       [1:0]    system_plic_logic_bmb_cmd_payload_fragment_length;
  wire       [31:0]   system_plic_logic_bmb_cmd_payload_fragment_data;
  wire       [0:0]    system_plic_logic_bmb_cmd_payload_fragment_context;
  wire                system_plic_logic_bmb_rsp_valid;
  wire                system_plic_logic_bmb_rsp_ready;
  wire                system_plic_logic_bmb_rsp_payload_last;
  wire       [0:0]    system_plic_logic_bmb_rsp_payload_fragment_source;
  wire       [0:0]    system_plic_logic_bmb_rsp_payload_fragment_opcode;
  wire       [31:0]   system_plic_logic_bmb_rsp_payload_fragment_data;
  wire       [0:0]    system_plic_logic_bmb_rsp_payload_fragment_context;
  wire                system_plic_logic_bus_readErrorFlag;
  wire                system_plic_logic_bus_writeErrorFlag;
  reg                 system_plic_logic_bus_readHaltTrigger;
  wire                system_plic_logic_bus_writeHaltTrigger;
  wire                system_plic_logic_bus_rsp_valid;
  wire                system_plic_logic_bus_rsp_ready;
  wire                system_plic_logic_bus_rsp_payload_last;
  wire       [0:0]    system_plic_logic_bus_rsp_payload_fragment_source;
  reg        [0:0]    system_plic_logic_bus_rsp_payload_fragment_opcode;
  reg        [31:0]   system_plic_logic_bus_rsp_payload_fragment_data;
  wire       [0:0]    system_plic_logic_bus_rsp_payload_fragment_context;
  wire                _zz_system_plic_logic_bus_rsp_ready;
  reg                 _zz_system_plic_logic_bus_rsp_ready_1;
  wire                _zz_system_plic_logic_bmb_rsp_valid;
  reg                 _zz_system_plic_logic_bmb_rsp_valid_1;
  reg                 _zz_system_plic_logic_bmb_rsp_payload_last;
  reg        [0:0]    _zz_system_plic_logic_bmb_rsp_payload_fragment_source;
  reg        [0:0]    _zz_system_plic_logic_bmb_rsp_payload_fragment_opcode;
  reg        [31:0]   _zz_system_plic_logic_bmb_rsp_payload_fragment_data;
  reg        [0:0]    _zz_system_plic_logic_bmb_rsp_payload_fragment_context;
  wire                when_Stream_l375_2;
  wire                system_plic_logic_bus_askWrite;
  wire                system_plic_logic_bus_askRead;
  wire                system_plic_logic_bmb_cmd_fire;
  wire                system_plic_logic_bus_doWrite;
  wire                system_plic_logic_bus_doRead;
  wire                when_BmbSlaveFactory_l33;
  wire                when_BmbSlaveFactory_l35;
  wire       [1:0]    system_cores_0_externalInterrupt_plic_target_threshold;
  wire       [1:0]    system_cores_0_externalInterrupt_plic_target_requests_0_priority;
  wire                system_cores_0_externalInterrupt_plic_target_requests_0_valid;
  reg        [1:0]    system_cores_0_externalInterrupt_plic_target_bestRequest_priority;
  reg                 system_cores_0_externalInterrupt_plic_target_bestRequest_valid;
  wire                system_cores_0_externalInterrupt_plic_target_iep;
  reg                 system_plic_logic_bridge_claim_valid;
  reg                 system_plic_logic_bridge_completion_valid;
  reg                 system_plic_logic_bridge_coherencyStall_willIncrement;
  wire                system_plic_logic_bridge_coherencyStall_willClear;
  reg        [0:0]    system_plic_logic_bridge_coherencyStall_valueNext;
  reg        [0:0]    system_plic_logic_bridge_coherencyStall_value;
  wire                system_plic_logic_bridge_coherencyStall_willOverflowIfInc;
  wire                system_plic_logic_bridge_coherencyStall_willOverflow;
  wire                when_PlicMapper_l122;
  reg        [1:0]    _zz_system_cores_0_externalInterrupt_plic_target_threshold;
  reg                 system_plic_logic_bridge_targetMapping_0_targetCompletion_valid;
  reg                 system_cores_0_externalInterrupt_plic_target_iep_regNext;
  wire                system_plic_ctrl_slaveModel_arbiterGen_oneToOne_arbiter_cmd_valid;
  wire                system_plic_ctrl_slaveModel_arbiterGen_oneToOne_arbiter_cmd_ready;
  wire                system_plic_ctrl_slaveModel_arbiterGen_oneToOne_arbiter_cmd_payload_last;
  wire       [0:0]    system_plic_ctrl_slaveModel_arbiterGen_oneToOne_arbiter_cmd_payload_fragment_source;
  wire       [0:0]    system_plic_ctrl_slaveModel_arbiterGen_oneToOne_arbiter_cmd_payload_fragment_opcode;
  wire       [21:0]   system_plic_ctrl_slaveModel_arbiterGen_oneToOne_arbiter_cmd_payload_fragment_address;
  wire       [1:0]    system_plic_ctrl_slaveModel_arbiterGen_oneToOne_arbiter_cmd_payload_fragment_length;
  wire       [31:0]   system_plic_ctrl_slaveModel_arbiterGen_oneToOne_arbiter_cmd_payload_fragment_data;
  wire       [0:0]    system_plic_ctrl_slaveModel_arbiterGen_oneToOne_arbiter_cmd_payload_fragment_context;
  wire                system_plic_ctrl_slaveModel_arbiterGen_oneToOne_arbiter_rsp_valid;
  wire                system_plic_ctrl_slaveModel_arbiterGen_oneToOne_arbiter_rsp_ready;
  wire                system_plic_ctrl_slaveModel_arbiterGen_oneToOne_arbiter_rsp_payload_last;
  wire       [0:0]    system_plic_ctrl_slaveModel_arbiterGen_oneToOne_arbiter_rsp_payload_fragment_source;
  wire       [0:0]    system_plic_ctrl_slaveModel_arbiterGen_oneToOne_arbiter_rsp_payload_fragment_opcode;
  wire       [31:0]   system_plic_ctrl_slaveModel_arbiterGen_oneToOne_arbiter_rsp_payload_fragment_data;
  wire       [0:0]    system_plic_ctrl_slaveModel_arbiterGen_oneToOne_arbiter_rsp_payload_fragment_context;
  wire                system_clint_ctrl_slaveModel_arbiterGen_oneToOne_arbiter_cmd_valid;
  wire                system_clint_ctrl_slaveModel_arbiterGen_oneToOne_arbiter_cmd_ready;
  wire                system_clint_ctrl_slaveModel_arbiterGen_oneToOne_arbiter_cmd_payload_last;
  wire       [0:0]    system_clint_ctrl_slaveModel_arbiterGen_oneToOne_arbiter_cmd_payload_fragment_source;
  wire       [0:0]    system_clint_ctrl_slaveModel_arbiterGen_oneToOne_arbiter_cmd_payload_fragment_opcode;
  wire       [15:0]   system_clint_ctrl_slaveModel_arbiterGen_oneToOne_arbiter_cmd_payload_fragment_address;
  wire       [1:0]    system_clint_ctrl_slaveModel_arbiterGen_oneToOne_arbiter_cmd_payload_fragment_length;
  wire       [31:0]   system_clint_ctrl_slaveModel_arbiterGen_oneToOne_arbiter_cmd_payload_fragment_data;
  wire       [0:0]    system_clint_ctrl_slaveModel_arbiterGen_oneToOne_arbiter_cmd_payload_fragment_context;
  wire                system_clint_ctrl_slaveModel_arbiterGen_oneToOne_arbiter_rsp_valid;
  wire                system_clint_ctrl_slaveModel_arbiterGen_oneToOne_arbiter_rsp_ready;
  wire                system_clint_ctrl_slaveModel_arbiterGen_oneToOne_arbiter_rsp_payload_last;
  wire       [0:0]    system_clint_ctrl_slaveModel_arbiterGen_oneToOne_arbiter_rsp_payload_fragment_source;
  wire       [0:0]    system_clint_ctrl_slaveModel_arbiterGen_oneToOne_arbiter_rsp_payload_fragment_opcode;
  wire       [31:0]   system_clint_ctrl_slaveModel_arbiterGen_oneToOne_arbiter_rsp_payload_fragment_data;
  wire       [0:0]    system_clint_ctrl_slaveModel_arbiterGen_oneToOne_arbiter_rsp_payload_fragment_context;
  reg                 _zz_timerInterrupt;
  reg                 _zz_softwareInterrupt;
  wire                io_apbSlave_0_input_slaveModel_arbiterGen_oneToOne_arbiter_cmd_valid;
  wire                io_apbSlave_0_input_slaveModel_arbiterGen_oneToOne_arbiter_cmd_ready;
  wire                io_apbSlave_0_input_slaveModel_arbiterGen_oneToOne_arbiter_cmd_payload_last;
  wire       [0:0]    io_apbSlave_0_input_slaveModel_arbiterGen_oneToOne_arbiter_cmd_payload_fragment_source;
  wire       [0:0]    io_apbSlave_0_input_slaveModel_arbiterGen_oneToOne_arbiter_cmd_payload_fragment_opcode;
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
  wire       [23:0]   system_bmbPeripheral_bmb_withoutMask_cmd_payload_fragment_address_3;
  wire       [1:0]    system_bmbPeripheral_bmb_withoutMask_cmd_payload_fragment_length_3;
  wire       [31:0]   system_bmbPeripheral_bmb_withoutMask_cmd_payload_fragment_data_3;
  wire       [0:0]    system_bmbPeripheral_bmb_withoutMask_cmd_payload_fragment_context_3;
  wire                system_bmbPeripheral_bmb_withoutMask_rsp_valid_3;
  wire                system_bmbPeripheral_bmb_withoutMask_rsp_ready_3;
  wire                system_bmbPeripheral_bmb_withoutMask_rsp_payload_last_3;
  wire       [0:0]    system_bmbPeripheral_bmb_withoutMask_rsp_payload_fragment_source_3;
  wire       [0:0]    system_bmbPeripheral_bmb_withoutMask_rsp_payload_fragment_opcode_3;
  wire       [31:0]   system_bmbPeripheral_bmb_withoutMask_rsp_payload_fragment_data_3;
  wire       [0:0]    system_bmbPeripheral_bmb_withoutMask_rsp_payload_fragment_context_3;
  wire                when_BmbSlaveFactory_l77;
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
