pfeffermominee690-afk/ti60-five-style-fit34/(commit log)

2026-11-02 Add five-style firmware, models and concise build instructions
    [config.txt]
2026-11-03 Crop display previews and add both enclosure design galleries
2026-11-03 Show front and rear camera layouts with both development boards
2026-11-03 Add gesture switching video and animated README preview
2026-11-03 Update main camera project to fit37 and preserve fit34 recovery
